mattmccrink/afc-drone/rpi_ros2/docs/RUNBOOK.md

# AFC Drone — Cold-Start Runbook (Pi → rosbridge → PC dashboard)

Every-time operation, from a powered-off Pi to live data in the browser.
(First-time install/config is in BRINGUP.md; this assumes it's all built.)

Chain:
```
PX4 ──TELEM2 ↔ Pi PL011 (serial0/ttyAMA0)──> uXRCE agent ─┐
                                                          ├─ ROS graph ─> rosbridge :9090 ─> browser (PC)
tiny(RP2350) Serial2 ↔ Pi uart3 (ttyAMA1) ──> bridge node ─┘
```

---

## 0. Power on — and check it
Power the Pi from a solid **5V/3A** supply (brownouts under load have bitten this
rig repeatedly). Once up and SSH'd in:
```bash
vcgencmd get_throttled        # want 0x0. nonzero = under-voltage; fix power first.
```

## 1. Get onto the Pi
The Pi is `phoenix` and answers to **`phoenix.local`** (mDNS) as well as its fixed
address `192.168.137.10`, over a cable or through the Doodle link (both bridge the
same Ethernet segment):
- `ssh pi@phoenix.local`   (or `ssh pi@192.168.137.10`)
- dashboard URL: `ws://192.168.137.10:9090` (the default), or `ws://phoenix.local:9090`.
  Prefer the IP over the radio: mDNS is multicast, and a mesh link may carry it poorly.

Once Wi-Fi is disabled (`sudo pi_setup.sh wifi-off`), the old hotspot
(`10.42.0.1`) no longer exists. If you are ever locked out, see *Recovery* in
`tools/pi_setup.sh`: every setting it makes can be undone from the SD card's boot
partition on any laptop.

## 2. Confirm the two serial devices
Both links are soldered GPIO UARTs (no USB, no FTDI). The FC is on `serial0`
(`ttyAMA0`); the Tiny is on `uart3` (`ttyAMA1`, base `fe201600`). **The Tiny is
never `ttyAMA0`.**
```bash
ls -l /dev/serial0                 # -> ttyAMA0
dmesg | grep -iE 'ttyAMA'          # fe201600 = uart3 = the Tiny
```

## 3. Source the environment (every terminal)
```bash
source /opt/ros/humble/setup.bash
source ~/afc-drone/rpi_ros2/install/setup.bash
```
(Put these two lines in ~/.bashrc so every new shell is ready.)

## 4+5. Start the agent + bridge (+ rosbridge) — one command
```bash
ros2 launch afc_bridge afc_system.launch.py      # defaults: agent_dev=/dev/serial0, serial_port=/dev/ttyAMA1
```
Watch for `create_client` / `create_participant` from the agent and
`opened /dev/ttyAMA1 (exclusive)` from the bridge (which also starts the #25873
keep-alive). Restarting the agent mid-session is recoverable on firmware built with
`patch_px4.py` steps 4-6: the FC reconnects a few seconds after the agent is back
(D1/D2, 2026-09-28). While DDS is down the arm token stalls; past 10 s the Tiny
reverts to SBUS. On older firmware an agent restart wedged the FC until a reboot.

Running pieces by hand instead:
```bash
MicroXRCEAgent serial --dev /dev/serial0 -b 921600                      # Terminal A
ros2 run afc_bridge bridge_node --ros-args -p serial_port:=/dev/ttyAMA1 # Terminal B
```

## 6. rosbridge (websocket :9090) — started by afc_system; by hand:
```bash
ros2 launch rosbridge_server rosbridge_websocket_launch.xml
```
Serves `ws://<pi-ip>:9090` on all interfaces. Can be started any time after the
graph is up (it just exposes existing topics).

## 7. Verify on the Pi (before touching the browser)
```bash
ros2 topic list                       # see /afc/* and /fmu/out/*
ros2 topic echo /afc/health           # serial up, ctrl/sensor/comp ~25 Hz, crc 0
ros2 topic echo /afc/compressor       # thermal_suspect false; rpm/temp when armed
ros2 topic hz /fmu/out/vehicle_torque_setpoint   # steady, max ~0.07s (NOT 1.0s)
# on the FC (nsh): uxrce_dds_client status  -> connected, Payload rx != 0
```

## 8. Open the dashboard on the PC
- Open `afc_dashboard.html` in a browser (next to QGC).
- Set the URL box to the address from step 1 (`ws://10.42.0.1:9090` hotspot, or
  `ws://192.168.137.10:9090` ethernet) and click **Connect**.
- Link dot goes green; valve schematic, charts, and health populate.

---

## 9. Preflight check (before every flight)
The agent and bridge normally start at boot as services (`microxrce-agent`,
`afc-bridge`); the preflight checks for those, so run it against the services, not a
hand-started stack. With the vehicle disarmed and the FC powered:
```bash
afc_preflight            # flight: sim/bench builds, missing venturis, no RC = FAIL
afc_preflight --bench    # bench: those become WARN
```
One PASS / WARN / FAIL line per check, ending GO or NO-GO (exit status 0 = GO).
Clear every FAIL before arming for flight.

## Shutdown
Ctrl-C the launch (or terminals C → B → A). The Tiny reverts to SBUS/SAFE when
the bridge stops (by design); if it was armed with no SBUS it terminates after 3 s.

## Quick troubleshooting
| Symptom | Check |
|---|---|
| Ethernet drops during heavy work | power/brownout — `vcgencmd get_throttled`; use `--parallel-workers 1` for builds |
| agent: no `create_client` | wrong `--dev`, baud, or MAVLink still on TELEM2 |
| bridge: `refusing to open ...` | `serial_port` points at the FC UART — the Tiny is `/dev/ttyAMA1` |
| dashboard red "ESC THERMAL" banner | ESC ≥ 90 °C and rpm sagging > 10 % below target ≥ 3 s — ESC likely self-derating |
| `/fmu/out/*` stalls ~1 Hz | bridge node not running (keep-alive only fires with it up) |
| topics exist but dashboard empty | wrong ws URL/IP, or message-type strings in the HTML CFG don't match `ros2 topic type` |
| dashboard link dot stays red | rosbridge not running, port 9090 blocked, or PC not on the Pi's subnet |
| `crc errors` climbing in health | serial/baud/desync on the tiny link |
| valve fills look wrong-scale | set `valveAbsMax` / bar full-scales in the HTML CFG block |
