mattmccrink/afc-drone/rpi_ros2/src/afc_bridge/afc_bridge/bridge_node.py

#!/usr/bin/env python3
"""
bridge_node.py -- Pi ROS2 supervisor/bridge between the Pixhawk (uXRCE-DDS) and
the RP2350 valve/sensor node over the Pi's uart3 (Tiny Serial2, 230400).

  Pixhawk --DDS--> [THIS NODE] --uart3(CMD,ARM)--> RP2350
  RP2350  --uart3(CTRL_TLM,SENSOR_TLM,COMP_TLM)--> [THIS NODE] --> ROS2 topics

Ports: the Tiny is on uart3 (PL011 @ fe201600 -> /dev/ttyAMA1 on this Pi). The FC
is on /dev/serial0 -> /dev/ttyAMA0 and belongs to the uXRCE-DDS agent: this node
refuses to open it (forbidden_ports) and opens its own port exclusively.

The node is a supervisor + bridge, NOT an in-loop controller: it forwards
pre-allocation control demand, relays the arm token with correct liveness
semantics, and republishes the tiny's telemetry as typed messages. Allocation
stays on the RP2350 (coanda-slot effectiveness + independent reversion); the FC
only supplies the normalised torque/thrust demand. All wire handling lives in
framing.py (byte-compatible with the tiny) and the arm-token safety logic in
arm_token.py; both are unit-tested off-hardware.

Command source (PX4 1.14+ control allocation, all uXRCE-DDS / px4_msgs):
  * CMD demand: vehicle_torque_setpoint (xyz = roll/pitch/yaw) +
    vehicle_thrust_setpoint (z = thrust), normalised [-1,1] body FRD, ~250 Hz.
    Rate-controller output PRE-allocation -- what FT_CMD expects, since the tiny
    does its own allocation.
  * ARM: vehicle_status.arming_state == ARMING_STATE_ARMED. STRICT boolean --
    the tiny does not reason about FC failsafe; the FC executes failsafe, which
    flips arming_state, which propagates here. QGC/arming/missions ride the
    Doodle MAVLink link straight to the FC, not this node.

Fail-safe intent preserved on the Pi side:
  * CMD is forwarded ONLY while BOTH setpoints (torque and thrust) are fresh --
    if either goes stale we stop sending, letting the tiny's USB_CMD_TIMEOUT_MS
    revert to SBUS.
  * the arm token advances ONLY while vehicle_status is fresh (see arm_token.py).
Both degrade toward the tiny's own reversion rather than freezing a last value.
"""
from __future__ import annotations

import time

import rclpy
from rclpy.node import Node
from rclpy.qos import QoSPresetProfiles

from std_msgs.msg import Header

from afc_bridge import framing as F
from afc_bridge.arm_token import ArmTokenTx
from afc_bridge.cmd_gate import setpoints_fresh
from afc_bridge.qgc_alert import AirAlerter, encode_text

# All FC I/O is px4_msgs over uXRCE-DDS now (no MAVROS). Resolved lazily so a
# plain `colcon build` doesn't hard-require px4_msgs at build time.
try:
    from px4_msgs.msg import (VehicleTorqueSetpoint, VehicleThrustSetpoint,
                              VehicleStatus, OffboardControlMode)
except Exception:  # pragma: no cover - present at runtime once px4_msgs is built
    VehicleTorqueSetpoint = VehicleThrustSetpoint = VehicleStatus = OffboardControlMode = None
try:
    from px4_msgs.msg import MavlinkLog
except Exception:  # pragma: no cover
    MavlinkLog = None

from afc_bridge_msgs.msg import ValveNodeCtrl, ValveNodeSensor, ValveNodeHealth, ValveNodeComp

_MODE_STR = {0: "DISARMED", 1: "PRIMARY_ARMED", 2: "SBUS_REVERSION",
             3: "SAFE_HOLD", 4: "TERMINATED"}

try:
    import serial  # pyserial
except Exception:  # pragma: no cover
    serial = None


class BridgeNode(Node):
    def __init__(self):
        super().__init__("afc_bridge")

        # ---- parameters ----
        p = self.declare_parameter
        self.port_name = p("serial_port", "/dev/ttyAMA1").value      # Tiny = uart3
        # Never open the FC's DDS UART from here (a second opener would inject
        # CMD/ARM frames into the FC link). Compared after resolving symlinks.
        self.forbidden_ports = list(p("forbidden_ports",
                                      ["/dev/serial0", "/dev/ttyAMA0"]).value)
        agent_port = str(p("agent_port", "").value)     # afc_system passes agent_dev
        if agent_port:
            self.forbidden_ports.append(agent_port)
        self.torque_topic = p("torque_topic", "/fmu/out/vehicle_torque_setpoint").value
        self.thrust_topic = p("thrust_topic", "/fmu/out/vehicle_thrust_setpoint").value
        # PX4 1.16+ publishes versioned messages under a _v1 suffix. vehicle_status
        # is a DEFAULT DDS publication so it carries the suffix; the setpoints below
        # are plain because they're hand-added to dds_topics.yaml under those names.
        self.status_topic = p("status_topic", "/fmu/out/vehicle_status_v1").value 
        # FRD z is down, so a multicopter's climb thrust is NEGATIVE in
        # thrust_setpoint.xyz[2]; the CMD throttle slot wants a positive
        # magnitude. Default -1 flips it; CONFIRM against live data before trust.
        self.thrust_sign = float(p("thrust_sign", -1.0).value)
        self.cmd_rate_hz = float(p("cmd_rate_hz", 50.0).value)
        self.cmd_stale_s = float(p("cmd_stale_after_s", 0.1).value)
        self.mdot_target = float(p("mdot_target_gps", 40.0).value)
        self.thrust_lo = float(p("thrust_lo", 0.0).value)
        self.thrust_hi = float(p("thrust_hi", 1.0).value)
        self.arm_hb_hz = float(p("arm_heartbeat_hz", 1.0).value)
        self.arm_stale_s = float(p("arm_stale_after_s", 0.5).value)
        self.ctrl_out = p("ctrl_topic", "/afc/ctrl_tlm").value
        self.sensor_out = p("sensor_topic", "/afc/sensor_tlm").value

        # ---- state ----
        self._ser = None
        self._reader = F.FrameReader()
        self._torque = None              # latest (x,y,z) = roll,pitch,yaw demand
        self._thrust = None              # latest (x,y,z); z is the thrust axis
        # Freshness is keyed on the OLDER of the two setpoints (cmd_gate): CMD
        # carries both, so a stalled thrust topic must not ride on live torque.
        self._torque_rx_mono = None      # monotonic arrival time of each setpoint
        self._thrust_rx_mono = None
        self._armtx = ArmTokenTx(
            send=self._send_arm,
            heartbeat_s=1.0 / self.arm_hb_hz,
            stale_after_s=self.arm_stale_s,
        )
        self._tlm_offset_ms = None       # est. (node_ms - ros_ms), for logging
        self._tlm_offset0_ms = None
        self.health_out = p("health_topic", "/afc/health").value
        # Air-delivery CAUTION/WARNING -> QGC via PX4 (mavlink_log -> STATUSTEXT).
        # Needs /fmu/in/mavlink_log in the FC's dds_topics.yaml; harmless without.
        self.qgc_alerts = bool(p("qgc_alerts", True).value)
        self.qgc_alert_topic = p("qgc_alert_topic", "/fmu/in/mavlink_log").value

        # ---- health/observability counters ----
        # With the console gone, a silent framing desync looks identical to
        # "no data" -- these make the difference visible. crc_errors lives on
        # the reader; the rest are tallied here and rolled into a 1 Hz rate.
        self._ctrl_count = 0             # CTRL_TLM frames since last health tick
        self._sensor_count = 0           # SENSOR_TLM frames since last health tick
        self._frames_ok = 0             # cumulative good frames
        self._last_source = 255          # from most recent CTRL_TLM (255 = none yet)
        self._last_armed = False
        # fault-tree fields from the tiny (CTRL_TLM ext; default = pre-update firmware)
        self._last_mode = 0
        self._last_term = False
        self._last_elig_fc = False
        self._last_elig_sbus = False
        self._last_sbus_sw = False
        self._last_desat_rp = 1.0
        self._last_desat_yaw = 1.0
        self._last_surf = False
        self._last_thermal = False
        self._last_air_sev = 0
        self._last_air_causes = 0
        self._health_t = time.monotonic()

        # ---- publishers ----
        self._ctrl_pub = self.create_publisher(ValveNodeCtrl, self.ctrl_out, 10)
        self._sensor_pub = self.create_publisher(ValveNodeSensor, self.sensor_out, 10)
        self._health_pub = self.create_publisher(ValveNodeHealth, self.health_out, 10)
        self._keepalive_pub = self.create_publisher(OffboardControlMode, "/fmu/in/offboard_control_mode",QoSPresetProfiles.SENSOR_DATA.value)
        self._alerter = AirAlerter()
        self._fc_ts_us = None            # latest FC timestamp (vehicle_status), for mavlink_log
        self._fc_ts_mono = 0.0
        self._qgc_pub = None
        if self.qgc_alerts and MavlinkLog is not None:
            self._qgc_pub = self.create_publisher(MavlinkLog, self.qgc_alert_topic,
                                                  QoSPresetProfiles.SENSOR_DATA.value)
        self.comp_out  = p("comp_topic", "/afc/compressor").value
        self._comp_pub = self.create_publisher(ValveNodeComp, self.comp_out, 10)
        self._comp_count = 0    # COMP_TLM frames since last health tick -> comp_hz
        # ---- subscribers ----
        # SENSOR_DATA QoS = best-effort/volatile/keep-last, which matches BOTH
        # MAVROS and PX4's uXRCE-DDS publishers. A default (reliable) QoS here is
        # the classic "topic exists but no messages arrive" trap against PX4.
        sensor_qos = QoSPresetProfiles.SENSOR_DATA.value
        if VehicleStatus is not None:
            self.create_subscription(VehicleStatus, self.status_topic,
                                     self._on_status, sensor_qos)
            self.create_subscription(VehicleTorqueSetpoint, self.torque_topic,
                                     self._on_torque, sensor_qos)
            self.create_subscription(VehicleThrustSetpoint, self.thrust_topic,
                                     self._on_thrust, sensor_qos)
        else:
            self.get_logger().error(
                "px4_msgs not importable; CMD+ARM inputs disabled. Build px4_msgs.")

        # ---- timers ----
        self.create_timer(1.0 / self.cmd_rate_hz, self._cmd_timer)
        self.create_timer(0.05, self._arm_timer)          # 20 Hz drive; TX self-paces
        self.create_timer(0.002, self._rx_timer)          # ~500 Hz serial drain
        self.create_timer(1.0, self._reconnect_timer)     # port keepalive
        self.create_timer(1.0, self._health_timer)        # 1 Hz health + rosout

        self._open_serial()
        self.get_logger().info(
            f"afc_bridge up: port={self.port_name} "
            f"cmd<=torque({self.torque_topic})+thrust({self.thrust_topic}) "
            f"arm<={self.status_topic} cmd_rate={self.cmd_rate_hz}Hz "
            f"arm_hb={self.arm_hb_hz}Hz mdot={self.mdot_target}g/s "
            f"thrust_sign={self.thrust_sign:+.0f}")
        self.create_timer(0.2, self._keepalive_timer)   # 5 Hz -- just keeps FC rx != 0

    def _keepalive_timer(self):
        # Inert message purely to keep uxrce_dds_client's Payload rx > 0, which
        # avoids the 1 s blocking ping (PX4 #25873). All fields false: commands
        # nothing. Real command authority is torque/thrust READ from the FC;
        # allocation is on the RP2350. This is a workaround for a firmware bug --
        # remove once the client is patched to gate connectivity on TX alone.
        m = OffboardControlMode()
        m.timestamp = int(self.get_clock().now().nanoseconds / 1000)  # PX4 wants microseconds
        m.position = False
        m.velocity = False
        m.acceleration = False
        m.attitude = False
        m.body_rate = False
        m.thrust_and_torque = False
        m.direct_actuator = False
        self._keepalive_pub.publish(m)
    # ---------------------------------------------------------------- serial
    def _port_forbidden(self) -> bool:
        import os
        try:
            me = os.path.realpath(self.port_name)
        except Exception:  # noqa: BLE001
            me = self.port_name
        for fp in self.forbidden_ports:
            if me == os.path.realpath(fp):
                return True
        return False

    def _open_serial(self):
        if serial is None:
            self.get_logger().error("pyserial not installed (python3-serial).")
            return
        if self._port_forbidden():
            self.get_logger().error(
                f"refusing to open {self.port_name}: it is the FC DDS port "
                f"({self.forbidden_ports}). The Tiny is on uart3 (/dev/ttyAMA1).")
            return
        try:
            # exclusive=True is pyserial's ADVISORY flock (stops other pyserial
            # users); TIOCEXCL below is the kernel-enforced lock: any further open()
            # of this tty by a non-root process fails with EBUSY.
            self._ser = serial.Serial(self.port_name, baudrate=230400, timeout=0,
                                      exclusive=True)
            try:
                import fcntl
                import termios
                fcntl.ioctl(self._ser.fileno(), termios.TIOCEXCL)
            except Exception as e:  # noqa: BLE001
                self.get_logger().warn(f"TIOCEXCL failed on {self.port_name} ({e})")
            self.get_logger().info(f"opened {self.port_name} (exclusive)")

        except Exception as e:  # noqa: BLE001
            self._ser = None
            self.get_logger().warn(f"serial open failed ({e}); will retry")

    def _reconnect_timer(self):
        if self._ser is None:
            self._open_serial()

    def _write(self, data: bytes):
        if self._ser is None:
            return
        try:
            self._ser.write(data)
        except Exception as e:  # noqa: BLE001
            self.get_logger().warn(f"serial write failed ({e}); dropping port")
            self._ser = None

    # ------------------------------------------------------------ subscribers
    def _on_status(self, msg):
        # STRICT: armed iff arming_state == ARMING_STATE_ARMED. No failsafe/nav
        # reasoning here -- the FC owns failsafe and flips arming_state, which
        # propagates through this one field. Freshness keyed on receipt time.
        armed = (msg.arming_state == VehicleStatus.ARMING_STATE_ARMED)
        self._armtx.note_state(armed, time.monotonic())
        # FC clock reference: PX4 drops a mavlink_log older than 5 s by ITS clock,
        # and with DDS timesync off the Pi must stamp in FC time itself.
        self._fc_ts_us = int(msg.timestamp)
        self._fc_ts_mono = time.monotonic()

    def _on_torque(self, msg):
        self._torque = (float(msg.xyz[0]), float(msg.xyz[1]), float(msg.xyz[2]))
        self._torque_rx_mono = time.monotonic()

    def _on_thrust(self, msg):
        self._thrust = (float(msg.xyz[0]), float(msg.xyz[1]), float(msg.xyz[2]))
        self._thrust_rx_mono = time.monotonic()

    def _cmd_fresh(self, now: float) -> bool:
        # both setpoints present, and the OLDER arrival within the window.
        return setpoints_fresh(now, self._torque_rx_mono, self._thrust_rx_mono,
                               self.cmd_stale_s)

    # ----------------------------------------------------------------- timers
    def _cmd_timer(self):
        if not self._cmd_fresh(time.monotonic()):
            return  # stale/incomplete setpoints -> stop forwarding, tiny reverts
        roll, pitch, yaw = self._torque          # torque xyz -> r/p/y demand
        thrust = self.thrust_sign * self._thrust[2]   # thrust axis, sign-corrected
        self._write(F.build_cmd(roll, pitch, yaw, thrust, self.mdot_target,
                                thrust_lo=self.thrust_lo, thrust_hi=self.thrust_hi))

    def _arm_timer(self):
        self._armtx.tick(time.monotonic())

    def _send_arm(self, armed: bool, counter: int):
        self._write(F.build_arm(armed, counter))

    def _rx_timer(self):
        if self._ser is None:
            return
        try:
            n = self._ser.in_waiting
            chunk = self._ser.read(n or 1)
        except Exception as e:  # noqa: BLE001
            self.get_logger().warn(f"serial read failed ({e}); dropping port")
            self._ser = None
            return
        if not chunk:
            return
        for fr in self._reader.feed(chunk):
            if fr.type == F.FT_CTRL_TLM:
                self._publish_ctrl(fr.payload)
            elif fr.type == F.FT_SENSOR_TLM:
                self._publish_sensor(fr.payload)
            elif fr.type == F.FT_COMP_TLM:
                self._publish_comp(fr.payload)
    # ------------------------------------------------------------- publishing
    def _stamp(self) -> Header:
        h = Header()
        h.stamp = self.get_clock().now().to_msg()
        return h

    def _publish_ctrl(self, payload: bytes):
        try:
            d = F.decode_ctrl_tlm(payload)
        except ValueError as e:
            self.get_logger().warn(str(e))
            return
        m = ValveNodeCtrl()
        m.header = self._stamp()
        m.source = d["source"]
        m.armed = d["armed"]
        m.comp_mode = d["comp_mode"]
        m.flow_fallback = d["flow_fallback"]
        m.rpm_target = d["rpm_target"]
        m.n_valid = d["n_valid"]
        m.valve = d["valve"]
        m.servo_us = d["servo_us"]
        m.surf_engaged = d["surf_engaged"]
        m.surf_switch = d["surf_switch"]
        m.surf = d["surf"]
        m.air_sev = d["air_sev"]
        m.air_causes = d["air_causes"]
        m.node_stamp_ms = int(d["node_stamp_ms"])
        for k in ("flags2_valid", "sbus_lost", "sbus_ok", "bench_build", "cal_flash",
                  "sim_sensors", "sim_sbus", "sim_primary"):
            setattr(m, k, bool(d[k]))
        m.sbus_stats_valid = bool(d["sbus_stats_valid"])
        for k in ("sbus_n_frames", "sbus_n_lost", "sbus_n_fs", "sbus_n_bad", "sbus_gap_ms"):
            setattr(m, k, int(d[k]))
        self._ctrl_pub.publish(m)
        self._qgc_alert(d["air_sev"], d["air_causes"], d["armed"])
        self._ctrl_count += 1
        self._frames_ok += 1
        self._last_source = d["source"]     # tiny's readback of our CMD path
        self._last_armed = d["armed"]       # tiny's readback of our arm token
        self._last_mode = d["mode"]         # fault-tree extras (0 on pre-update fw)
        self._last_term = d["terminated"]
        self._last_elig_fc = d["elig_fc"]
        self._last_elig_sbus = d["elig_sbus"]
        self._last_sbus_sw = d["sbus_sw"]
        self._last_desat_rp = d["desat_rp"]
        self._last_desat_yaw = d["desat_yaw"]
        self._last_surf = d["surf_engaged"]
        self._last_air_sev = d["air_sev"]
        self._last_air_causes = d["air_causes"]

    def _qgc_alert(self, level: int, causes: int, armed: bool):
        if self._qgc_pub is None:
            return
        for sev, text in self._alerter.update(int(level), int(causes), time.monotonic()):
            if self._fc_ts_us is None:
                self.get_logger().warn(f"[qgc] no FC clock yet, not sent: {text}")
                continue
            m = MavlinkLog()
            m.timestamp = self._fc_ts_us + int((time.monotonic() - self._fc_ts_mono) * 1e6)
            m.text = encode_text(text)
            m.severity = sev
            self._qgc_pub.publish(m)
            self.get_logger().info(f"[qgc] sev={sev} {text}")

    def _publish_sensor(self, payload: bytes):
        try:
            d = F.decode_sensor_tlm(payload)
        except ValueError as e:
            self.get_logger().warn(str(e))
            return
        m = ValveNodeSensor()
        m.header = self._stamp()
        m.node_stamp_ms = d["node_stamp_ms"]
        m.p_up = [float(x) for x in d["p_up"]]
        m.p_lo = [float(x) for x in d["p_lo"]]
        m.t_die = [float(x) for x in d["t_die"]]
        m.mdot = [float(x) for x in d["mdot"]]
        m.mdot_total = float(d["mdot_total"])
        m.valid = d["valid"]
        m.why = [int(x) & 0xFF for x in d["why"]]
        self._sensor_pub.publish(m)

        self._sensor_count += 1
        self._frames_ok += 1

        # running node<->ROS offset estimate (telemetry sanity / logging only).
        ros_ms = m.header.stamp.sec * 1000 + m.header.stamp.nanosec // 1_000_000
        raw = int(d["node_stamp_ms"]) - ros_ms
        if (self._tlm_offset0_ms is None
                or abs(raw - self._tlm_offset0_ms) > 2_000_000_000):
            self._tlm_offset0_ms = raw
        self._tlm_offset_ms = raw - self._tlm_offset0_ms
    
    def _publish_comp(self, payload: bytes):
        try:
            d = F.decode_comp_tlm(payload)
        except ValueError as e:
            self.get_logger().warn(str(e))
            return
        m = ValveNodeComp()
        m.header = self._stamp()
        m.volt = float(d["volt"])
        m.amp = float(d["amp"])
        m.rpm = int(d["rpm"])
        m.temp_c = int(d["temp_c"])
        m.err = int(d["err"])
        m.tlm_ok = bool(d["tlm_ok"])
        m.node_stamp_ms = int(d["node_stamp_ms"])
        m.thermal_suspect = bool(d["thermal_suspect"])
        self._comp_pub.publish(m)
        if m.thermal_suspect and not self._last_thermal:
            self.get_logger().warn(
                f"[comp] ESC THERMAL-DERATE SUSPECTED: {m.temp_c} C, {m.rpm} rpm")
        self._last_thermal = m.thermal_suspect
        self._comp_count += 1
        self._frames_ok += 1
    # ---------------------------------------------------------------- health
    def _health_timer(self):
        now = time.monotonic()
        dt = max(now - self._health_t, 1e-3)
        ctrl_hz = self._ctrl_count / dt
        sensor_hz = self._sensor_count / dt
        comp_hz = self._comp_count / dt
        self._ctrl_count = 0
        self._sensor_count = 0
        self._comp_count = 0
        self._health_t = now

        cmd_fresh = self._cmd_fresh(now)
        arm_fresh = not self._armtx.frozen

        m = ValveNodeHealth()
        m.header = self._stamp()
        m.serial_connected = self._ser is not None
        m.ctrl_hz = float(ctrl_hz)
        m.sensor_hz = float(sensor_hz)
        m.comp_hz = float(comp_hz)
        m.crc_errors = int(self._reader.crc_errors)
        m.frames_ok = int(self._frames_ok)
        m.last_source = int(self._last_source) if self._last_source != 255 else 255
        m.last_armed = bool(self._last_armed)
        m.mode = int(self._last_mode)
        m.mode_str = _MODE_STR.get(self._last_mode, "?")
        m.terminated = bool(self._last_term)
        m.elig_fc = bool(self._last_elig_fc)
        m.elig_sbus = bool(self._last_elig_sbus)
        m.sbus_sw = bool(self._last_sbus_sw)
        m.desat_rp = float(self._last_desat_rp)
        m.desat_yaw = float(self._last_desat_yaw)
        m.surf_engaged = bool(self._last_surf)
        m.air_sev = int(self._last_air_sev)
        m.air_causes = int(self._last_air_causes)
        m.air_str = F.AIR_NAMES.get(m.air_sev, "?") + "".join(
            " " + name for bit, name in F.AIR_CAUSES.items() if m.air_causes & bit)
        m.cmd_fresh = bool(cmd_fresh)
        m.arm_fresh = bool(arm_fresh)
        m.arm_counter = int(self._armtx.counter)
        raw_off = int(self._tlm_offset_ms) if self._tlm_offset_ms is not None else 0
        m.tlm_offset_ms = max(-2147483648, min(2147483647, raw_off))
        self._health_pub.publish(m)

        # human-readable 1 Hz line -- the 'health' console you lost, on rosout.
        src = {0: "PRIMARY", 1: "SBUS", 2: "SAFE", 255: "--"}.get(self._last_source, "?")
        self.get_logger().info(
            f"[health] ser={'up' if m.serial_connected else 'DOWN'} "
            f"ctrl={ctrl_hz:4.1f}Hz sens={sensor_hz:4.1f}Hz comp={comp_hz:4.1f}Hz crc={m.crc_errors} "
            f"mode={m.mode_str} src={src} armed={m.last_armed} term={m.terminated} "
            f"elig[fc={m.elig_fc} sbus={m.elig_sbus} sw={m.sbus_sw}] "
            f"cmd_fresh={m.cmd_fresh} arm_fresh={m.arm_fresh} "
            f"desat={m.desat_rp:.2f}/{m.desat_yaw:.2f} surf={m.surf_engaged} air=[{m.air_str}] "
            f"armctr={m.arm_counter} off={m.tlm_offset_ms}ms")


def main(args=None):
    rclpy.init(args=args)
    node = BridgeNode()
    try:
        rclpy.spin(node)
    except KeyboardInterrupt:
        pass
    finally:
        node.destroy_node()
        rclpy.shutdown()


if __name__ == "__main__":
    main()
