mattmccrink/afc-drone/rp2350_valve_node/sensors.ino

// =============================================================================
//  sensors.ino  --  REAL MS5837-02BA pipeline over PCA9548A  (core 1)
//
//  Compiled only when USE_REAL_I2C == 1 (otherwise sensors_sim.ino provides the
//  same seam). Two absolute -02BA per valve (upstream + throat); dp by
//  subtraction with a per-valve ground zero (g_dp_zero, from 'zero'); density
//  from the UPSTREAM absolute + its die temp. Between-sensor differential with
//  local static.
//
//  Pipeline: conversion-in-flight state machine. A conversion is kicked to all
//  sensors at once (broadcast: open every populated channel, one convert to
//  0x76), then read back sequentially CONV_LATENCY_TICKS later (one channel at a
//  time). Latency lets OSR 8192 (~18 ms) live under a 10 ms tick. The frame is
//  (re)published every tick so downstream staleness detection is unaffected.
//
//  Noise handling for the low-full-scale venturi: max OSR + a per-sensor EMA on
//  compensated pressure (SENS_EMA_ALPHA).
//
//  Mapping (open decision #1) is the editable table below. Convention: adjacent
//  channels per valve, lower channel = upstream (higher static) = ROLE_UP.
// =============================================================================
#include "config.h"
#include "types.h"

#if USE_REAL_I2C
#include <Wire.h>
#include "vent_health.h"

// ---------------------------------------------------------------------------
//  SENSOR MAP  --  EDIT as the tree populates (open decision #1).
//  Bench default: two sensors on mux 0x70, ch0 = valve0 upstream, ch1 = throat.
// ---------------------------------------------------------------------------
static const SensorSlot SENSOR_MAP[] = {
  //Left wing
  { ADDR_PCA9545_A, 0, 0, ROLE_UP },
  { ADDR_PCA9545_A, 1, 0, ROLE_LO },
  { ADDR_PCA9545_A, 2, 1, ROLE_UP },
  { ADDR_PCA9545_A, 3, 1, ROLE_LO },
  //Right wing
  { ADDR_PCA9545_B, 0, 2, ROLE_UP },
  { ADDR_PCA9545_B, 1, 2, ROLE_LO },
  { ADDR_PCA9545_B, 2, 3, ROLE_UP },
  { ADDR_PCA9545_B, 3, 3, ROLE_LO },
  //Canard
  { ADDR_PCA9545_C, 0, 4, ROLE_UP },
  { ADDR_PCA9545_C, 1, 4, ROLE_LO },
  { ADDR_PCA9545_C, 2, 5, ROLE_UP },
  { ADDR_PCA9545_C, 3, 5, ROLE_LO },
  // ---- example once fully populated (adjacent pairs, up = lower channel) ----
  // { 0x70, 2, 1, ROLE_UP }, { 0x70, 3, 1, ROLE_LO },
  // { 0x70, 4, 2, ROLE_UP }, { 0x70, 5, 2, ROLE_LO },
  // { 0x70, 6, 3, ROLE_UP }, { 0x70, 7, 3, ROLE_LO },
  // { 0x71, 0, 4, ROLE_UP }, { 0x71, 1, 4, ROLE_LO },
  // { 0x71, 2, 5, ROLE_UP }, { 0x71, 3, 5, ROLE_LO },
};
static const int N_SLOTS = sizeof(SENSOR_MAP) / sizeof(SENSOR_MAP[0]);

// ---- per-slot caches ----
static uint16_t s_prom[SENSOR_COUNT][8];
static bool     s_prom_ok[SENSOR_COUNT];
static uint32_t s_rawD1[SENSOR_COUNT], s_rawD2[SENSOR_COUNT];
static bool     s_have1[SENSOR_COUNT], s_have2[SENSOR_COUNT];
static float    s_P[SENSOR_COUNT], s_T[SENSOR_COUNT];   // s_P is EMA-filtered
static bool     s_ema_init[SENSOR_COUNT];

// ---- per-valve slot lookup ----
static int8_t   s_up[VALVE_COUNT], s_lo[VALVE_COUNT];

// ---- health (vent_health.h) ----
static SlotHealth s_h[SENSOR_COUNT];
static VentGate   s_gate[VALVE_COUNT];
static uint8_t    s_why[VALVE_COUNT];     // last published reason (console)

// ---- Valve constants ----
//ET and MMC calibration using Alicat mass flow sensor, 9/10/2026
static float K_VENTURI[6] =   {0.8963f,0.8425f,0.876f,0.8425f,0.8705f,0.8496f}; //~31 mBar at 400 SLPM

// ---- unique mux list ----
static uint8_t  s_mux[8]; static int s_nmux = 0;

// ---- pipeline state (conversion-in-flight; supports multi-tick latency) ----
static bool     s_conv_pending    = false;
static uint32_t s_conv_ready_tick = 0;
static int      s_conv_type       = 0;    // 0 = D1 pressure, 1 = D2 temperature
static uint32_t s_conv_count      = 0;    // conversions issued (drives D2 cadence)

// ---------------------------------------------------------------------------
//  MS5837-02BA compensation (validated at bring-up). 64-bit intermediates.
// ---------------------------------------------------------------------------
static void ms_compensate(const uint16_t prom[8], uint32_t D1, uint32_t D2,
                          float& p_mbar, float& t_C) {
  int64_t C1=prom[1], C2=prom[2], C3=prom[3], C4=prom[4], C5=prom[5], C6=prom[6];
  int64_t dT   = (int64_t)D2 - (C5 << 8);
  int64_t TEMP = 2000 + (dT * C6) / 8388608LL;
  int64_t OFF  = (C2 << 17) + (C4 * dT) / 64;
  int64_t SENS = (C1 << 16) + (C3 * dT) / 128;
  int64_t Ti=0, OFFi=0, SENSi=0;
  if (TEMP < 2000) {
    int64_t d = TEMP - 2000;
    Ti    = (11 * dT * dT) >> 35;
    OFFi  = (31 * d * d) >> 3;
    SENSi = (63 * d * d) >> 5;
  }
  OFF -= OFFi; SENS -= SENSi;
  int64_t P = ((((int64_t)D1 * SENS) >> 21) - OFF) >> 15;
  p_mbar = P / 100.0f;
  t_C    = (TEMP - Ti) / 100.0f;
}

// ---------------------------------------------------------------------------
//  Mux + MS5837 low level
// ---------------------------------------------------------------------------
static void mux_select_only(uint8_t target, uint8_t ch) {
  for (int i = 0; i < s_nmux; ++i) {
    if (!i2c_ok()) return;             // breaker open (always true during setup)
    Wire.beginTransmission(s_mux[i]);
    Wire.write(s_mux[i] == target ? (uint8_t)(1u << ch) : (uint8_t)0x00);
    Wire.endTransmission();
  }
}

static void mux_open_all_populated() {
  for (int i = 0; i < s_nmux; ++i) {
    uint8_t mask = 0;
    for (int k = 0; k < N_SLOTS; ++k) if (SENSOR_MAP[k].mux == s_mux[i]) mask |= (1u << SENSOR_MAP[k].ch);
    if (!i2c_ok()) return;
    Wire.beginTransmission(s_mux[i]);
    Wire.write(mask);
    Wire.endTransmission();
  }
}

static bool ms_read_adc(uint32_t& out) {
  Wire.beginTransmission(ADDR_MS5837);
  Wire.write(MS_ADC_READ_CMD);
  if (Wire.endTransmission() != 0) return false;
  if (Wire.requestFrom((int)ADDR_MS5837, 3) != 3) return false;
  out = ((uint32_t)Wire.read() << 16) | ((uint32_t)Wire.read() << 8) | Wire.read();
  return true;
}

static void mux_close_all() {
  for (int i = 0; i < s_nmux; ++i) {
    if (!i2c_ok()) return;
    Wire.beginTransmission(s_mux[i]);
    Wire.write(0x00);              // all channels off
    Wire.endTransmission();
  }
}

static uint8_t ms_crc4(uint16_t prom[8]) {
  uint16_t rem = 0, saved0 = prom[0];
  prom[0] &= 0x0FFF; prom[7] = 0;
  for (int cnt = 0; cnt < 16; cnt++) {
    if (cnt % 2 == 1) rem ^= (uint16_t)(prom[cnt >> 1] & 0x00FF);
    else              rem ^= (uint16_t)(prom[cnt >> 1] >> 8);
    for (uint8_t b = 8; b > 0; b--)
      rem = (rem & 0x8000) ? (uint16_t)((rem << 1) ^ 0x3000) : (uint16_t)(rem << 1);
  }
  prom[0] = saved0;
  return (uint8_t)((rem >> 12) & 0x0F);
}

static bool ms_read_prom(int slot) {
  Wire.beginTransmission(ADDR_MS5837); Wire.write(MS_RESET_CMD); Wire.endTransmission();
  delay(12);
  for (uint8_t w = 0; w < 7; ++w) {
    Wire.beginTransmission(ADDR_MS5837); Wire.write((uint8_t)(0xA0 + w * 2));
    if (Wire.endTransmission() != 0) return false;
    if (Wire.requestFrom((int)ADDR_MS5837, 2) != 2) return false;
    s_prom[slot][w] = ((uint16_t)Wire.read() << 8) | Wire.read();
  }
  uint16_t tmp[8]; memcpy(tmp, s_prom[slot], sizeof(tmp));
  return ((s_prom[slot][0] >> 12) & 0x0F) == ms_crc4(tmp);
}

// Reprintable boot/health summary for the sensor path (also called at setup).
void sensors_health_print() {
  Serial.println(F("[health] sensor path: REAL (MS5837-02BA)"));
  for (int k = 0; k < N_SLOTS; ++k)
    Serial.printf("[health] slot%d mux0x%02X ch%u valve%u %s : PROM %s\n",
                  k, SENSOR_MAP[k].mux, SENSOR_MAP[k].ch, SENSOR_MAP[k].valve,
                  SENSOR_MAP[k].role == ROLE_UP ? "UP" : "LO",
                  s_prom_ok[k] ? "OK" : "FAIL");
}

// Per-venturi reason + per-sensor counters ('vhealth'). Runs on core 0 and
// reads core-1 counters without a lock: 32-bit reads are atomic, so each
// number is real, but a line can mix values from adjacent ticks. Diagnostic only.
void sensors_vhealth_print() {
  uint32_t now = millis();
  Serial.println(F("[vh] venturi  reason     (valid = OK; fallback if fewer than MIN_VALID_VALVES)"));
  for (int v = 0; v < VALVE_COUNT; ++v)
    Serial.printf("[vh] v%d       %s\n", v, vh_name(s_why[v]));
  Serial.println(F("[vh] slot mux  ch valve role state    ok      fail    spike  stale_ev frozen_ev lossy_ev score same d1_age_ms"));
  for (int k = 0; k < N_SLOTS; ++k) {
    const SlotHealth& h = s_h[k];
    Serial.printf("[vh] %-4d 0x%02X %-2u %-5u %-4s %-8s %-7lu %-7lu %-6lu %-8lu %-9lu %-8lu %-5u %-4u %ld\n",
      k, SENSOR_MAP[k].mux, SENSOR_MAP[k].ch, SENSOR_MAP[k].valve,
      SENSOR_MAP[k].role == ROLE_UP ? "UP" : "LO", vh_name(h.state),
      (unsigned long)h.n_ok, (unsigned long)h.n_fail, (unsigned long)h.n_spike,
      (unsigned long)h.n_stale_ev, (unsigned long)h.n_frozen_ev, (unsigned long)h.n_lossy_ev,
      (unsigned)h.fail_score, (unsigned)h.same_d1,
      h.seen_d1 ? (long)(now - h.last_d1_ms) : -1L);
  }
}

// ---------------------------------------------------------------------------
//  Setup: build mux list + valve lookup, cache PROM per sensor
// ---------------------------------------------------------------------------
void sensors_setup() {
  static_assert(sizeof(SENSOR_MAP) / sizeof(SENSOR_MAP[0]) <= SENSOR_COUNT,
                "SENSOR_MAP has more slots than SENSOR_COUNT");
  for (int v = 0; v < VALVE_COUNT; ++v) { s_up[v] = -1; s_lo[v] = -1; s_why[v] = VH_NODATA; }
  s_nmux = 0;

  for (int k = 0; k < N_SLOTS; ++k) {
    const SensorSlot& s = SENSOR_MAP[k];
    if (s.role == ROLE_UP) s_up[s.valve] = k; else s_lo[s.valve] = k;
    bool seen = false;
    for (int i = 0; i < s_nmux; ++i) if (s_mux[i] == s.mux) seen = true;
    if (!seen && s_nmux < (int)sizeof(s_mux)) s_mux[s_nmux++] = s.mux;
    s_have1[k] = s_have2[k] = false;
    s_ema_init[k] = false;
  }

  for (int k = 0; k < N_SLOTS; ++k) {
    mux_select_only(SENSOR_MAP[k].mux, SENSOR_MAP[k].ch);
    s_prom_ok[k] = ms_read_prom(k);
  }
  sensors_health_print();   // best-effort at boot; also available via 'health'
}

// ---------------------------------------------------------------------------
//  100 Hz tick
// ---------------------------------------------------------------------------
void sensors_tick(uint32_t tick) {
  uint32_t now = millis();

  // ---- 1) read back a conversion that has become ready ----
  if (s_conv_pending && (int32_t)(tick - s_conv_ready_tick) >= 0) {
    for (int k = 0; k < N_SLOTS; ++k) {
      if (!s_prom_ok[k]) continue;
      if (!i2c_ok()) break;                 // breaker open: unread slots age toward STALE
      mux_select_only(SENSOR_MAP[k].mux, SENSOR_MAP[k].ch);
      if (!i2c_ok()) break;                 // never read through a half-done mux select
      uint32_t raw = 0;
      bool xfer = ms_read_adc(raw);
      // Bad transfers, 0 / 0xFFFFFF and D1 spikes never reach compensation.
      if (sh_on_read(s_h[k], s_conv_type, xfer, raw, now)) {
        if (s_conv_type == 0) { s_rawD1[k] = raw; s_have1[k] = true; }
        else                  { s_rawD2[k] = raw; s_have2[k] = true; }
      }
      if (s_have1[k] && s_have2[k]) {
        float P, T;
        ms_compensate(s_prom[k], s_rawD1[k], s_rawD2[k], P, T);
        if (!s_ema_init[k]) { s_P[k] = P; s_ema_init[k] = true; }
        else                  s_P[k] += SENS_EMA_ALPHA * (P - s_P[k]);   // EMA on pressure
        s_T[k] = T;                                                      // temp slow: unfiltered
      }
    }
    s_conv_pending = false;
    mux_close_all();
  }

  // ---- 2) health: evaluate every sensor slot ----
  uint8_t sh[SENSOR_COUNT];
  for (int k = 0; k < SENSOR_COUNT; ++k) sh[k] = VH_UNMAPPED;
  for (int k = 0; k < N_SLOTS; ++k) {
    sh[k] = sh_eval(s_h[k], s_prom_ok[k], now);
    // A faulted slot restarts its EMA on recovery instead of blending from a
    // value that may be long stale.
    if (sh[k] == VH_STALE || sh[k] == VH_FROZEN || sh[k] == VH_LOSSY) s_ema_init[k] = false;
  }

  // ---- 3) assemble + publish per-valve frame (every tick; holds between updates) ----
  SensorFrame out{};   // built locally; published below in one short copy (types.h)
  float total = 0.0f; uint8_t nvalid = 0;

  for (int v = 0; v < VALVE_COUNT; ++v) {
    int up = s_up[v], lo = s_lo[v];
    bool mapped = (up >= 0 && lo >= 0);
    // Values are published whenever data exists (so a frozen / stale reading
    // stays visible for diagnosis); VALIDITY is decided separately below.
    bool paired = mapped && s_prom_ok[up] && s_prom_ok[lo] && s_have1[up] && s_have1[lo];

    float pu = paired ? s_P[up] : 0.0f;
    float pl = paired ? s_P[lo] : 0.0f;
    float td = paired ? s_T[up] : 0.0f;   // density temp from the upstream sensor

    bool range_ok = paired &&
                    pu >= MS_P_RANGE_MIN && pu <= MS_P_RANGE_MAX &&
                    pl >= MS_P_RANGE_MIN && pl <= MS_P_RANGE_MAX &&
                    td >= MS_T_RANGE_MIN && td <= MS_T_RANGE_MAX;

    float dp = ((pu - pl) - g_dp_zero[v]);          // zero-corrected differential (mbar)

    // VALIDITY = sensor + pair health only. Flow presence is a separate
    // deadband test, so a healthy venturi at zero flow still counts.
    VentInputs vin;
    vin.mapped   = mapped;
    vin.sh_up    = mapped ? sh[up] : (uint8_t)VH_UNMAPPED;
    vin.sh_lo    = mapped ? sh[lo] : (uint8_t)VH_UNMAPPED;
    vin.injected = g_fault_valve[v] || g_fault_aggregate;
    vin.range_ok = range_ok;
    vin.dp_corr  = dp;
    uint8_t why  = vent_gate(s_gate[v], vent_reason(vin), now);
    bool valid   = (why == VH_OK);
    s_why[v]     = why;

    float mdot = 0.0f;
    if (valid) {
      if (dp >= VENTURI_DP_MIN) {                 // above the noise deadband -> real flow
        float rho = (pu * 100.0f) / (R_AIR * (td + 273.15f));   // ideal gas, upstream static
        mdot = K_VENTURI[v] * AREA_INLET* rho * sqrtf(2.0f * dp * 100.0f/ (rho * (AREA_RATIO * AREA_RATIO - 1) )) *1000;     // dp mbar -> Pa; guarded dp>0, mdot kg-->g is *1000
      }
      total += mdot;                              // 0 when below deadband (no phantom flow)
      nvalid++;                                   // healthy sensor counts, flowing or not
    }

    out.p_up[v]  = pu;
    out.p_lo[v]  = pl;
    out.t_die[v] = td;                                   // upstream (density temp)
    out.t_lo[v]  = paired ? s_T[lo] : 0.0f;              // throat (cal/tempco)
    out.mdot[v]  = mdot;
    out.valid[v] = valid ? 1 : 0;
    out.why[v]   = why;
  }

  out.mdot_total = total;
  out.n_valid    = nvalid;
  for (int s = 0; s < SERVO_COUNT; ++s) out.servo_us[s] = g_servo_us_echo[s];
  g_sensor_pub.publish(out);

  // ---- 4) if nothing is in flight, kick the next conversion (broadcast) ----
  if (!s_conv_pending && i2c_ok()) {
    int type = ((s_conv_count % D2_CADENCE_TICKS) == 0) ? 1 : 0;   // D2 temp vs D1 pressure
    mux_open_all_populated();
    if (!i2c_ok()) return;                  // muxes not all open: don't start a conversion
    Wire.beginTransmission(ADDR_MS5837);
    Wire.write(type ? MS_D2_CMD : MS_D1_CMD);
    Wire.endTransmission();
    if (!i2c_ok()) return;                  // convert command timed out: retry after back-off
    s_conv_type       = type;
    s_conv_ready_tick = tick + CONV_LATENCY_TICKS;
    s_conv_pending    = true;
    s_conv_count++;
  }
}

#endif // USE_REAL_I2C
