mattmccrink/afc-drone/rp2350_valve_node/console.ino

// =============================================================================
//  console.ino  --  Human bench console over USB CDC  (core 0)
//
//  Drives the whole node on a bare board: force sources, arm/disarm, simulate
//  primary loss and SBUS failsafe, set sticks and mass-flow target, inject
//  sensor faults, and save calibration. Line-based; type 'help'.
// -----------------------------------------------------------------------------
#include "config.h"
#include "air_state.h"

static bool    con_mon_on = false;
static bool    con_pstream = false;   // 2 Hz LabVIEW pressure stream
// servo bring-up sweep state (core 0 computes waveform, core 1 writes)
static bool    sweep_active = false;
static uint16_t sweep_min = 1000, sweep_max = 2000;
static uint32_t sweep_ms = 2000, sweep_t0 = 0;
static char    con_line[96];
static uint8_t con_len = 0;
// servo step state (core0 computes staircase; core1 writes via the man table)
static bool     step_active = false;
static uint16_t step_begin = 1000, step_end = 2000;
static int32_t  step_size  = 100;      // us per step (sign set from begin/end)
static uint32_t step_dwell = 200;      // ms held at each step
static uint32_t step_t0    = 0;

static const char* src_name(Source s) {
  switch (s) { case SRC_PRIMARY: return "PRIMARY"; case SRC_SBUS: return "SBUS"; default: return "SAFE"; }
}
static const char* mode_name(CompMode m) {
  switch (m) { case COMP_TRACK: return "TRACK"; case COMP_DIRECT: return "DIRECT";
               case COMP_FALLBACK: return "FALLBACK"; default: return "STOPPED"; }
}

static void print_status() {
  Serial.printf(
    "[st] src=%-7s arm=%d(live=%d) term=%d prim=%d | elig fc=%d sbus=%d sw=%d | comp=%-8s rpm=%5u%s | mdot=%.1f/%.1f g/s nvalid=%u%s%s | air=%s(0x%02X) | v=[%d %d %d %d %d %d] surf=%s[%d %d %d %d] desat=%.2f/%.2f | cal=%s | hb=%lu drop=%lu\n",
    src_name(g_status.source), g_status.armed?1:0, g_status.arm_live?1:0, g_status.terminated?1:0, g_status.primary_present?1:0,
    arb_fc_eligible()?1:0, g_sbus_arm_seen_disarmed?1:0, g_sbus_arm?1:0,
    mode_name(g_status.comp_mode), g_status.rpm_target, g_status.comp_thermal ? " THERMAL" : "",
    (double)g_status.mdot_total, (double)g_status.mdot_target, g_status.n_valid,
    g_status.flow_fallback ? " FALLBACK" : "", g_status.sensor_stale ? " STALE" : "",
    air_name(g_status.air_sev), g_status.air_causes,
    g_valve_dbg[0], g_valve_dbg[1], g_valve_dbg[2], g_valve_dbg[3], g_valve_dbg[4], g_valve_dbg[5],
    g_status.surf_active ? (g_surf_force >= 0 ? "ON(forced)" : "ON")
      : g_status.surf_engaged ? "sw-on/idle" : (g_surf_force >= 0 ? "off(forced)" : "off"),
    g_surf_dbg[0], g_surf_dbg[1], g_surf_dbg[2], g_surf_dbg[3],
    (double)g_alloc_s_rp, (double)g_alloc_s_yaw,
    g_cal_from_flash ? "flash" : "default", (unsigned long)g_core1_heartbeat, (unsigned long)g_tlm_dropped);
}

static void print_help() {
  Serial.println(F(
    "commands:\n"
    "  help                    this list\n"
    "  status                  one-shot status line\n"
    "  health                  reprint boot/health summary (sensor PROM, cal, liveness)\n"
    "  mon on|off              periodic status line (2 Hz)\n"
    "  src auto|primary|sbus|safe   force/release the active source\n"
    "  surf on|off|auto        force traditional surfaces / follow the SBUS switch (bench)\n"
    "  arm | disarm            simulated Pixhawk arm channel\n"
    "  prim on|off             simulate primary (Pi) presence\n"
    "  sbusfs on|off           simulate SBUS failsafe flag\n"
    "  sbuslost on|off         simulate SBUS frame-lost flag\n"
    "  sbus                    print real SBUS decode (raw ch, arm, surf)\n"
    "  stick R P Y T           set SBUS sticks (floats: roll pitch yaw throttle)\n"
    "  fault valve N on|off    inject per-valve sensor fault (N=0..5)\n"
    "  fault agg on|off        inject aggregate flow fault\n"
    "  mdot X                  set mass-flow target (g/s)\n"
    "  sens                    dump per-valve p_up/p_lo/dp/T/mdot from the frame\n"
    "  pstream on|off          2 Hz LabVIEW stream: !A=12 pressures, !B=12 temps\n"
    "  servo <A|B|C> <ch> <us> drive one PCA9685 channel (bring-up); servo off to stop\n"
    "  sweep <A|B|C> <ch> [min max ms]  triangle-sweep one channel (default 1000 2000 2000)\n"
    "  step <A|B|C> <ch> [min max step_us hold_ms]  step one channel (default 1000 2000 100 200)\n"
    "  save                    persist current calibration to LittleFS\n"
    "  map                     print servo -> valve map (servo s = board s/4, channel s%4)\n"
    "  map S V                 assign servo S (0..11) to valve V (0..5); 'save' to keep (I13)\n"
    "  zero                    capture no-flow dp offset per valve, then save\n"
    "  calshow                 calibration: all 12 servo fits (checked), gain/bias, dp_zero\n"
    "  vhealth                 per-venturi validity reason + per-sensor read/fault counters\n"
    "  air                     air-delivery severity, causes and the inputs behind them"));
#if BENCH_HOOKS
  Serial.println(F(
    "bench hooks (BENCH_HOOKS=1 -- not a flight build):\n"
    "  hang core0|core1        stall a core -> watchdog reset (T-S3 / T-S7)\n"
    "  tdrop N                 skip the next N Teensy frames, 20 ms each (T-C4 / T-C5)\n"
    "  i2cstick sda|scl <ms>|hold|persist N|off, i2cstick probe on|off\n"
    "                          hold an I2C line low at the pad: a stuck device (needs USE_REAL_I2C)"));
#endif
}

static bool eq(const char* a, const char* b) { return strcmp(a, b) == 0; }

// Resolve a servo-driver name to a device index: A/B/C (any case) or 0/1/2.
static int dev_index(const char* s) {
  if (!strcasecmp(s, "A") || eq(s, "0")) return 0;
  if (!strcasecmp(s, "B") || eq(s, "1")) return 1;
  if (!strcasecmp(s, "C") || eq(s, "2")) return 2;
  return -1;
}
static bool onoff(const char* s, bool& out) {
  if (eq(s,"on"))  { out = true;  return true; }
  if (eq(s,"off")) { out = false; return true; }
  return false;
}

// Triangle sweep position for the elapsed time in the period: min..max..min.
static uint16_t sweep_us_at(uint32_t now) {
  uint32_t p    = (now - sweep_t0) % sweep_ms;
  float    ph   = (float)p / (float)sweep_ms;                    // 0..1
  float    frac = (ph < 0.5f) ? (2.0f * ph) : (2.0f - 2.0f * ph); // 0..1..0
  return sweep_min + (uint16_t)lroundf(frac * (float)(sweep_max - sweep_min));
}

static void dispatch(char* line) {
  // tokenize on spaces
  char* tok[8]; int n = 0;
  char* p = strtok(line, " \t");
  while (p && n < 8) { tok[n++] = p; p = strtok(nullptr, " \t"); }
  if (n == 0) return;

  if (eq(tok[0], "help"))        { print_help(); }
  else if (eq(tok[0], "status")) { print_status(); }
  else if (eq(tok[0], "health")) {
    Serial.println(F("RP2350 valve/sensor node -- health"));
    Serial.printf("[health] last reset cause=%s  uptime=%lu s\n",
                  g_reset_cause, (unsigned long)(millis() / 1000));
    Serial.printf("[health] core1 heartbeat=%lu (should advance between calls)\n",
                  (unsigned long)g_core1_heartbeat);
    Serial.printf("[health] cal source=%s\n", g_cal_from_flash ? "flash" : "default");
    sensors_health_print();
    servos_health_print();
    i2c_guard_print();
    sensors_vhealth_print();
  }
  else if (eq(tok[0], "vhealth")) { sensors_vhealth_print(); }
  else if (eq(tok[0], "air")) {
    // held = why the displayed level is lit (what the dashboard/QGC show);
    // now = this instant. They differ while an intermittent fault holds the level up.
    for (int k = 0; k < 2; ++k) {
      uint8_t c = k ? g_status.air_causes_now : g_status.air_causes;
      if (k == 0)
        Serial.printf("[air] severity=%s  held=0x%02X", air_name(g_status.air_sev), c);
      else
        Serial.printf("[air] now=0x%02X", c);
      Serial.printf("%s%s%s%s%s%s%s", (c & AIR_C_TLM_LOST) ? " TLM_LOST" : "", (c & AIR_C_TLM_EMU) ? " TLM_EMU" : "",
        (c & AIR_C_VENT_PARTIAL) ? " VENT_PARTIAL" : "", (c & AIR_C_VENT_LOST) ? " VENT_LOST" : "",
        (c & AIR_C_FLOW_LOW) ? " FLOW_LOW" : "", (c & AIR_C_SENSOR_STALE) ? " SENSOR_STALE" : "",
        (c & AIR_C_TEENSY_LINK) ? " TEENSY_LINK" : "");
      if (k == 0 && g_status.air_sev != AIR_OK)
        Serial.printf("  (last seen %lu ms ago)", (unsigned long)(millis() - g_status.air_held_ms));
      Serial.println();
    }
    Serial.printf("[air] inputs: armed=%d term=%d teensy_ok=%d err=%d nvalid=%u stale=%d mdot=%.1f g/s (min %.1f)\n",
      g_status.armed?1:0, g_status.terminated?1:0, g_comp.ok?1:0, (int)g_comp.err,
      g_status.n_valid, g_status.sensor_stale?1:0, (double)g_status.mdot_total, (double)AIR_MDOT_MIN_GPS);
  }
  else if (eq(tok[0], "hang") || eq(tok[0], "tdrop")) {
#if BENCH_HOOKS
    if (eq(tok[0], "hang") && n >= 2 && eq(tok[1], "core0")) {
      // Core 0 stops here: no more WDT pets -> hardware reset in ~WDT_TIMEOUT_MS.
      // Core 1 keeps running and, after CMD_TIMEOUT_MS, drives the safe pose.
      Serial.println(F("[hang] core0 spinning; expect safe pose, then WATCHDOG reset"));
      Serial.flush();
      for (;;) { tight_loop_contents(); }
    } else if (eq(tok[0], "hang") && n >= 2 && eq(tok[1], "core1")) {
      // Core 1 stops; core 0 sees the heartbeat stall (CORE1_STALL_TRIP_MS),
      // withholds the pet -> reset. PCA9685s hold their last pulse meanwhile.
      g_hang_core1 = true;
      Serial.println(F("[hang] core1 spinning; expect WATCHDOG reset"));
    } else if (eq(tok[0], "tdrop") && n >= 2) {
      int k = atoi(tok[1]);
      if (k < 1 || k > 250) Serial.println(F("[tdrop] N must be 1..250"));
      else { g_tdrop = (uint16_t)k;
             Serial.printf("[tdrop] skipping next %d Teensy frame(s) (~%d ms; only while armed)\n",
                           k, k * (1000 / TEENSY_STREAM_HZ)); }
    } else Serial.println(F("usage: hang core0|core1 | tdrop N"));
#else
    Serial.println(F("[bench] hooks not compiled in (BENCH_HOOKS=0)"));
#endif
  }
  else if (eq(tok[0], "i2cstick")) {
#if BENCH_HOOKS
    bench_i2c_command(tok, n);
#else
    Serial.println(F("[bench] hooks not compiled in (BENCH_HOOKS=0)"));
#endif
  }
  else if (eq(tok[0], "mon") && n >= 2)  { onoff(tok[1], con_mon_on); }
  else if (eq(tok[0], "pstream") && n >= 2) {
    bool b; if (onoff(tok[1], b)) {
      con_pstream = b;
      if (b) {                              // one-time column headers for LabVIEW
        Serial.print("!HA");
        for (int v = 0; v < VALVE_COUNT; ++v) Serial.printf(",v%d_up,v%d_lo", v, v);
        Serial.println();
        Serial.print("!HB");
        for (int v = 0; v < VALVE_COUNT; ++v) Serial.printf(",v%d_up,v%d_lo", v, v);
        Serial.println();
      }
    }
  }
  else if (eq(tok[0], "surf") && n >= 2) {
    if      (eq(tok[1], "auto")) g_surf_force = -1;
    else if (eq(tok[1], "on"))   g_surf_force = 1;
    else if (eq(tok[1], "off"))  g_surf_force = 0;
    Serial.printf("[surf] %s\n", g_surf_force < 0 ? "follow SBUS switch" : (g_surf_force ? "FORCED ON" : "FORCED OFF"));
  }
  else if (eq(tok[0], "src") && n >= 2) {
    if      (eq(tok[1],"auto"))    arbitration_force(SRC_SAFE, false);
    else if (eq(tok[1],"primary")) arbitration_force(SRC_PRIMARY, true);
    else if (eq(tok[1],"sbus"))    arbitration_force(SRC_SBUS, true);
    else if (eq(tok[1],"safe"))    arbitration_force(SRC_SAFE, true);
    Serial.printf("[src] %s\n", tok[1]);
  }
  else if (eq(tok[0], "arm"))    { g_sim_arm_intent = true;  Serial.println(F("[arm] intent=ARMED")); }
  else if (eq(tok[0], "disarm")) { g_sim_arm_intent = false; Serial.println(F("[arm] intent=DISARMED")); }
  else if (eq(tok[0], "prim") && n >= 2) {
    bool b; if (onoff(tok[1], b)) { g_status.primary_present = b; Serial.printf("[prim] %d\n", b?1:0); }
  }
  else if (eq(tok[0], "sbusfs") && n >= 2)   { bool b; if (onoff(tok[1], b)) g_sbus_failsafe  = b; }
  else if (eq(tok[0], "sbuslost") && n >= 2) { bool b; if (onoff(tok[1], b)) g_sbus_framelost = b; }
  else if (eq(tok[0], "stick") && n >= 5) {
    g_sbus_in.roll     = atof(tok[1]);
    g_sbus_in.pitch    = atof(tok[2]);
    g_sbus_in.yaw      = atof(tok[3]);
    g_sbus_in.throttle = atof(tok[4]);
    Serial.printf("[stick] r=%.2f p=%.2f y=%.2f t=%.2f\n",
      (double)g_sbus_in.roll,(double)g_sbus_in.pitch,(double)g_sbus_in.yaw,(double)g_sbus_in.throttle);
  }
  else if (eq(tok[0], "fault") && n >= 3) {
    if (eq(tok[1], "agg")) { bool b; if (onoff(tok[2], b)) { g_fault_aggregate = b; Serial.printf("[fault] agg=%d\n", b?1:0);} }
    else if (eq(tok[1], "valve") && n >= 4) {
      int idx = atoi(tok[2]); bool b;
      if (idx >= 0 && idx < VALVE_COUNT && onoff(tok[3], b)) { g_fault_valve[idx] = b; Serial.printf("[fault] valve%d=%d\n", idx, b?1:0);}
    }
  }
  else if (eq(tok[0], "servo")) {
    if (n >= 2 && eq(tok[1], "off")) {
      g_servo_manual = false; sweep_active = false;
        for (int d = 0; d < PCA9685_COUNT; ++d)
        for (int c = 0; c < PCA9685_MAX_CH; ++c) g_servo_man_tbl[d][c] = 0;
      Serial.println(F("[servo] manual OFF (back to curve-fit path)"));
    } else if (n >= 4) {
      int d = dev_index(tok[1]); int ch = atoi(tok[2]); int us = atoi(tok[3]);
      if (d < 0)                              Serial.println(F("[servo] bad device (A/B/C)"));
      else if (ch < 0 || ch >= PCA9685_MAX_CH) Serial.printf("[servo] bad ch (0..%d)\n", PCA9685_MAX_CH-1);
      else if (us < SERVO_US_MIN || us > SERVO_US_MAX) Serial.printf("[servo] bad us (%d..%d)\n", SERVO_US_MIN, SERVO_US_MAX);
      else {
        sweep_active = false;
        //g_servo_man_dev = d; g_servo_man_ch = ch; g_servo_man_us = us; g_servo_manual = true;
        g_servo_man_tbl[d][ch] = (uint16_t)us;   // latch this channel; others untouched
        g_servo_manual = true;
        Serial.printf("[servo] hold dev%c ch%d = %d us\n", 'A'+d, ch, us);      }
    } else Serial.println(F("[servo] usage: servo <A|B|C> <ch> <us> | servo off"));
  }
  else if (eq(tok[0], "sweep") && n >= 3) {
    int d = dev_index(tok[1]); int ch = atoi(tok[2]);
    uint16_t mn = (n >= 4) ? atoi(tok[3]) : 1000;
    uint16_t mx = (n >= 5) ? atoi(tok[4]) : 2000;
    uint32_t ms = (n >= 6) ? (uint32_t)atoi(tok[5]) : 2000;
    if (d < 0)                                Serial.println(F("[sweep] bad device (A/B/C)"));
    else if (ch < 0 || ch >= PCA9685_MAX_CH)  Serial.printf("[sweep] bad ch (0..%d)\n", PCA9685_MAX_CH-1);
    else if (mn < SERVO_US_MIN || mx > SERVO_US_MAX || mn >= mx || ms < 100)
                                              Serial.println(F("[sweep] bad range/period (min<max, in us limits, ms>=100)"));
    else {
      sweep_min = mn; sweep_max = mx; sweep_ms = ms; sweep_t0 = millis();
      step_active  = false;                    // sweep and step are mutually exclusive
      sweep_active = true;
      g_servo_wave_dev = (uint8_t)d; g_servo_wave_ch = (uint8_t)ch;
      g_servo_man_tbl[d][ch] = mn;             // seat start position in the table
      g_servo_manual = true;
      Serial.printf("[sweep] dev%c ch%d %u..%u us over %lu ms (servo off to stop)\n",
                    'A'+d, ch, mn, mx, (unsigned long)ms);
    }
  }
  else if (eq(tok[0], "step") && n >= 3) {
    int d = dev_index(tok[1]); int ch = atoi(tok[2]);
    uint16_t b  = (n >= 4) ? atoi(tok[3]) : 1000;   // begin us
    uint16_t e  = (n >= 5) ? atoi(tok[4]) : 2000;   // end us
    uint16_t sz = (n >= 6) ? atoi(tok[5]) : 100;    // step size us (magnitude)
    uint32_t dw = (n >= 7) ? (uint32_t)atoi(tok[6]) : 200;  // dwell ms per step
    if (d < 0)                                Serial.println(F("[step] bad device (A/B/C)"));
    else if (ch < 0 || ch >= PCA9685_MAX_CH)  Serial.printf("[step] bad ch (0..%d)\n", PCA9685_MAX_CH-1);
    else if (b < SERVO_US_MIN || b > SERVO_US_MAX ||
             e < SERVO_US_MIN || e > SERVO_US_MAX)  Serial.printf("[step] bad us (%d..%d)\n", SERVO_US_MIN, SERVO_US_MAX);
    else if (sz == 0 || dw < 20)              Serial.println(F("[step] bad size/dwell (size>0, dwell>=20ms)"));
    else {
      step_begin = b; step_end = e;
      step_size  = (e >= b) ? (int32_t)sz : -(int32_t)sz;   // sign toward end
      step_dwell = dw; step_t0 = millis();
      sweep_active = false;                    // step and sweep are mutually exclusive
      step_active  = true;
      g_servo_wave_dev = (uint8_t)d; g_servo_wave_ch = (uint8_t)ch;
      g_servo_man_tbl[d][ch] = b;              // seat the first step immediately
      g_servo_manual = true;
      Serial.printf("[step] dev%c ch%d %u->%u us, %ld us/step, %lu ms dwell (servo off to stop)\n",
                    'A'+d, ch, b, e, (long)step_size, (unsigned long)dw);
    }
  }
  else if (eq(tok[0], "mdot") && n >= 2) { g_status.mdot_target = atof(tok[1]); Serial.printf("[mdot] target=%.1f\n",(double)g_status.mdot_target); }
  else if (eq(tok[0], "sens")) {
    SensorFrame fr;
    if (!g_sensor_pub.read_latest(fr)) { Serial.println(F("[sens] no frame")); return; }
    for (int v = 0; v < VALVE_COUNT; ++v) {
      //if (fr.p_up[v] <= 0.0f && fr.p_lo[v] <= 0.0f) continue;   // skip unpopulated valves
      float dpraw  = fr.p_up[v] - fr.p_lo[v];
      float dpcorr = dpraw - g_dp_zero[v];
      Serial.printf("[sens] v%d pu=%.2f pl=%.2f dpraw=%.2f dpz=%.2f dpcorr=%.2f mbar t=%.2f C mdot=%.3f g/s %s\n",
        v, (double)fr.p_up[v], (double)fr.p_lo[v], (double)dpraw,
        (double)g_dp_zero[v], (double)dpcorr, (double)fr.t_die[v],
        (double)fr.mdot[v], vh_name(fr.why[v]));
    }
    Serial.printf("[sens] total=%.3f g/s  nvalid=%u\n", (double)fr.mdot_total, fr.n_valid); 
  }           
  else if (eq(tok[0], "map")) {
    // I13: the servo -> valve assignment lives in the calibration blob (LittleFS).
    // Physical output of servo s is fixed: board 'A'+s/4, channel s%4.
    if (n >= 3) {
      if (g_status.armed) { Serial.println(F("[map] refused: disarm first")); return; }
      int sv = atoi(tok[1]), vv = atoi(tok[2]);
      if (sv < 0 || sv >= SERVO_COUNT || vv < 0 || vv >= VALVE_COUNT) {
        Serial.printf("[map] usage: map S V   (S 0..%d, V 0..%d)\n", SERVO_COUNT - 1, VALVE_COUNT - 1);
        return;
      }
      g_servo_valve_map[sv] = (uint8_t)vv;
      Serial.printf("[map] servo %d (board %c ch%d) -> valve %d  (not saved: 'save' to persist)\n",
                    sv, 'A' + sv / VALVE_SERVOS_PER_PCA, sv % VALVE_SERVOS_PER_PCA, vv + 1);
    }
    int per[VALVE_COUNT] = {0};
    for (int sv = 0; sv < SERVO_COUNT; ++sv) {
      int vv = g_servo_valve_map[sv];
      if (vv < VALVE_COUNT) per[vv]++;
      Serial.printf("[map] servo %2d  board %c ch%d  -> valve %d\n",
                    sv, 'A' + sv / VALVE_SERVOS_PER_PCA, sv % VALVE_SERVOS_PER_PCA, vv + 1);
    }
    for (int vv = 0; vv < VALVE_COUNT; ++vv)
      if (per[vv] != 2) Serial.printf("[map] NOTE valve %d has %d servo(s) (expected 2)\n", vv + 1, per[vv]);
  }
  else if (eq(tok[0], "save")) {
    // Flash writes pause core 1 (sensor reads + servo writes): never while armed.
    if (g_status.armed) { Serial.println(F("[cal] refused: disarm first")); return; }
    Serial.println(cal_save() ? F("[cal] saved") : F("[cal] SAVE FAILED"));
  }
  else if (eq(tok[0], "zero")) {
    // Capture the current no-flow (p_up - p_lo) per valve as the offset. MUST be
    // done at genuine no-flow (compressor stopped, still air).
    if (g_status.armed) { Serial.println(F("[zero] refused: disarm first (needs no flow)")); return; }
    if (g_last_armed_ms != 0 && (millis() - g_last_armed_ms) < ZERO_SETTLE_MS) {
      Serial.printf("[zero] refused: rotor may still be coasting; wait %lu s after disarm\n",
                    (unsigned long)((ZERO_SETTLE_MS - (millis() - g_last_armed_ms)) / 1000 + 1));
      return;
    }
    SensorFrame fr;
    if (!g_sensor_pub.read_latest(fr)) { Serial.println(F("[zero] no sensor frame")); return; }
    int n = 0;
    for (int v = 0; v < VALVE_COUNT; ++v) {
      // Only from a venturi whose sensors are healthy: an offset captured from a
      // stale / frozen sensor would bias dp for good. DPNEG is the exception --
      // a large raw offset between the pair is exactly what 'zero' removes.
      bool healthy = (fr.why[v] == VH_OK || fr.why[v] == VH_DPNEG);
      float off = fr.p_up[v] - fr.p_lo[v];
      if (healthy && fr.p_up[v] > 0.0f && fr.p_lo[v] > 0.0f && fabsf(off) > ZERO_MAX_OFFSET) {
        Serial.printf("[zero] v%d refused: offset %.2f mbar > %.1f -- check sensors/ports (kept %.2f)\n",
                      v, (double)off, (double)ZERO_MAX_OFFSET, (double)g_dp_zero[v]);
      } else if (healthy && fr.p_up[v] > 0.0f && fr.p_lo[v] > 0.0f) {
        g_dp_zero[v] = off;
        n++;
      } else if (fr.p_up[v] > 0.0f || fr.p_lo[v] > 0.0f) {
        Serial.printf("[zero] v%d skipped: %s (kept %.2f mbar)\n", v, vh_name(fr.why[v]),
                      (double)g_dp_zero[v]);
      }
    }
    bool ok = cal_save();
    Serial.printf("[zero] captured %d valve(s); save %s\n", n, ok ? "OK" : "FAILED");
  }
  else if (eq(tok[0], "calshow")) {
    Serial.printf("[cal] /cal.bin (map, gain/bias, zero): %s\n", g_cal_from_flash ? "loaded from flash" : "compiled defaults");
    servo_cal_report(true);
    Serial.print("[cal] valve gain/bias =");
    for (int v = 0; v < VALVE_COUNT; ++v) Serial.printf(" %.2f/%+.2f", (double)g_valve_gain[v], (double)g_valve_bias[v]);
    Serial.println();
    Serial.print("[cal] dp_zero =");
    for (int v = 0; v < VALVE_COUNT; ++v) Serial.printf(" %.2f", (double)g_dp_zero[v]);
    Serial.println(" mbar");
  }
   else if (eq(tok[0], "sbus")) {
#if USE_REAL_SBUS
    sbus_real_print();
#else
    Serial.println(F("[sbus] USE_REAL_SBUS=0 (simulated); use 'stick' / 'st'"));
#endif
}
  else { Serial.printf("? %s (try 'help')\n", tok[0]); }
}

// Fed one byte at a time by framing_pump() in text mode.
void console_feed_char(uint8_t c) {
  if (c == '\r') return;
  if (c == '\n') { con_line[con_len] = 0; if (con_len) dispatch(con_line); con_len = 0; return; }
  if (con_len < sizeof(con_line) - 1) con_line[con_len++] = (char)c;
}

void console_service(uint32_t now) {
  // servo sweep waveform: triangle min->max->min over sweep_ms; core 1 writes it
  if (g_servo_manual && sweep_active) {
  if (g_servo_manual && sweep_active)
    g_servo_man_tbl[g_servo_wave_dev][g_servo_wave_ch] = sweep_us_at(now);
  }
  else if (g_servo_manual && step_active) {
    uint32_t elapsed = now - step_t0;
    uint32_t nsteps  = elapsed / step_dwell;                 // how many dwell periods elapsed
    int32_t  us      = (int32_t)step_begin + (int32_t)nsteps * step_size;
    // clamp to the end and stop advancing once reached
    if (step_size > 0 && us >= (int32_t)step_end) us = step_end;
    if (step_size < 0 && us <= (int32_t)step_end) us = step_end;
    g_servo_man_tbl[g_servo_wave_dev][g_servo_wave_ch] = (uint16_t)us;
    // (leave step_active set so it HOLDS at step_end; 'servo off' to release)
  }

  // 2 Hz calibration stream for LabVIEW: all 12 pressures (!A)
  // and all 12 temps (!B), fixed width -- unpopulated valves read 0 until wired.
  if (con_pstream) {
    static uint32_t last_ps = 0;
    if ((now - last_ps) >= 500) {
      last_ps = now;
      SensorFrame fr;
      if (g_sensor_pub.read_latest(fr)) {
        Serial.print("!A");
        for (int v = 0; v < VALVE_COUNT; ++v)
          Serial.printf(",%.3f,%.3f", (double)fr.p_up[v], (double)fr.p_lo[v]);
        Serial.println();
        Serial.print("!B");
        for (int v = 0; v < VALVE_COUNT; ++v)
          Serial.printf(",%.3f,%.3f", (double)fr.t_die[v], (double)fr.t_lo[v]);
        Serial.println();
      }
    }
  }

  if (!con_mon_on) return;
  static uint32_t last = 0;
  if ((now - last) < 500) return;
  last = now;
  print_status();
}
