mattmccrink/afc-drone/rp2350_valve_node/types.h

// =============================================================================
//  types.h  --  Shared data structures + lock-free inter-core publisher
// =============================================================================
#pragma once
#include <Arduino.h>
#include "config.h"

// -----------------------------------------------------------------------------
//  Inter-core payloads  (mirror the architecture spec, section 5)
// -----------------------------------------------------------------------------

// core 0 -> core 1 : commanded valve positions (aero intent)
struct ValveCmd {
  int16_t  valve[VALVE_COUNT];   // aero-intent positions
  int16_t  surf[SURF_COUNT];     // surface commands, [-1000,1000], 0 = configured center
  uint32_t stamp_ms;             // set by core 0; core 1 checks staleness
};

// Why a venturi is (in)valid -- per valve, in SensorFrame.why[]. Worst-first
// order is not implied; the first failing check wins (see sensors.ino).
enum VentHealth : uint8_t {
  VH_OK = 0,
  VH_UNMAPPED,     // no up/lo pair in SENSOR_MAP
  VH_NOPROM,       // a sensor's PROM read/CRC failed at boot (never usable)
  VH_NODATA,       // no reading yet since boot
  VH_STALE,        // a sensor stopped answering (no good read within SENS_*STALE_MS)
  VH_FROZEN,       // a sensor returns identical raw counts (SENS_FROZEN_N)
  VH_LOSSY,        // a sensor fails too many reads (SENS_FAIL_WEIGHT / SENS_FAIL_TRIP)
  VH_RANGE,        // pressure / temperature outside physical limits
  VH_DPNEG,        // throat above upstream beyond VENTURI_DP_NEG_MAX
  VH_RECOVER,      // was faulty; waiting out SENS_RECOVER_MS clean time
  VH_INJECTED,     // console 'fault' injection
};

inline const char* vh_name(uint8_t w) {
  switch (w) {
    case VH_OK:       return "OK";
    case VH_UNMAPPED: return "UNMAPPED";
    case VH_NOPROM:   return "NOPROM";
    case VH_NODATA:   return "NODATA";
    case VH_STALE:    return "STALE";
    case VH_FROZEN:   return "FROZEN";
    case VH_LOSSY:    return "LOSSY";
    case VH_RANGE:    return "RANGE";
    case VH_DPNEG:    return "DPNEG";
    case VH_RECOVER:  return "RECOVER";
    case VH_INJECTED: return "INJECTED";
    default:          return "?";
  }
}

// core 1 -> core 0 : sensor + resolved-servo frame
struct SensorFrame {
  float    p_up[VALVE_COUNT];    // upstream pressure  (mbar)
  float    p_lo[VALVE_COUNT];    // throat pressure    (mbar)
  float    t_die[VALVE_COUNT];   // upstream sensor die temp (°C) -- density temp
  float    t_lo[VALVE_COUNT];    // throat sensor die temp (°C) -- cal/tempco telemetry
  float    mdot[VALVE_COUNT];    // per-valve mass flow (g/s)
  float    mdot_total;           // summed over VALID valves only
  uint16_t servo_us[SERVO_COUNT];// resolved servo commands (telemetry echo)
  uint8_t  valid[VALVE_COUNT];   // per-valve validity flag (see sensors_sim)
  uint8_t  why[VALVE_COUNT];     // VentHealth reason (VH_OK when valid)
  uint8_t  n_valid;              // count of valid valves
};

// -----------------------------------------------------------------------------
//  Node enums + app-level structs
//  (defined here, not in the main .ino, so Arduino's auto-generated prototypes
//   -- which are hoisted above the main sketch body -- can see these types.)
// -----------------------------------------------------------------------------
enum Source   { SRC_PRIMARY = 0, SRC_SBUS = 1, SRC_SAFE = 2 };
enum CompMode { COMP_STOPPED = 0, COMP_TRACK, COMP_DIRECT, COMP_FALLBACK };

// Derived operating mode for the fault-tree dashboard (single source of truth on
// the tiny; mirrored into CTRL_TLM -> /afc/health). Precedence: terminated wins,
// then disarmed, then the active source.
enum NodeMode : uint8_t {
  MODE_DISARMED       = 0,
  MODE_PRIMARY_ARMED  = 1,
  MODE_SBUS_REVERSION = 2,
  MODE_SAFE_HOLD      = 3,   // armed, no live source (pre-termination debounce)
  MODE_TERMINATED     = 4,
};

// A normalized command input; shared shape for every source.
struct StickInput {
  float    roll, pitch, yaw, throttle;   // roll/pitch/yaw in [-1,1], throttle [0,1]
  float    mdot_target;                  // g/s (primary only; sbus uses direct rpm)
  bool     valid;
  uint32_t stamp_ms;
};

struct NodeStatus {
  Source   source          = SRC_SAFE;
  bool     armed           = false;
  bool     arm_live        = false;
  bool     primary_present = true;       // sim: "is the Pi/primary alive?"
  uint16_t rpm_target      = 0;
  CompMode comp_mode       = COMP_STOPPED;
  float    mdot_total      = 0.0f;
  float    mdot_target     = MDOT_TARGET_DEFAULT;
  uint8_t  n_valid         = 0;
  bool     flow_fallback   = false;
  bool     sensor_stale    = false;
  bool     terminated      = false;      // latched flight-termination (total comms loss)
  bool     surf_engaged    = false;      // surface switch state (SBUS switch or console force)
  bool     surf_active     = false;      // surfaces actually allocated (switch && live source && !term)
  bool     comp_thermal    = false;      // ESC thermal-derate suspected (advisory)
  uint8_t  air_sev         = 0;          // air-delivery severity (AirSev, air_state.h), debounced
  uint8_t  air_causes      = 0;          // AIR_C_* bits behind the level on display (held; CTRL_TLM byte 55)
  uint8_t  air_causes_now  = 0;          // AIR_C_* bits this instant (console 'air' only)
  uint32_t air_held_ms     = 0;          // millis() of the last evaluation supporting air_sev
};

// Measured compressor telemetry, latched from the Motor Teensy's ESCPID_comm.
// Defined once in teensy_rx.ino; read by compressor_update, framing, console.
struct CompTlm {
  bool     ok      = false;   // fresh reply within the stale window
  uint16_t volt_cv = 0;       // pack voltage, 0.01 V
  uint16_t amp_ca  = 0;       // ESC current, 0.01 A
  int16_t  rpm10   = 0;       // mechanical rpm, units of 10 rpm
  int8_t   err     = 0;       // ESCCMD err code (0 ok, -10 TLM_LOST)
  uint8_t  temp_c  = 0;       // ESC temperature, deg C
  uint32_t tlm_ms  = 0;       // millis() of last good frame
};
extern CompTlm g_comp;        // declaration only -- definition lives in teensy_rx.ino

// One physical MS5837 behind the mux tree: its mux, channel, and which
// (valve, role) it serves. The real sensor path (sensors.ino) walks a table of
// these; the mapping is data, so open decision #1 is an edit, not a rewrite.
struct SensorSlot {
  uint8_t mux;      // mux I2C address (e.g. 0x70)
  uint8_t ch;       // channel 0..7
  uint8_t valve;    // 0..VALVE_COUNT-1
  uint8_t role;     // ROLE_UP or ROLE_LO
};

// Calibration blob persisted to LittleFS (see cal_littlefs.ino). Defined here,
// not in the tab, so Arduino's hoisted prototypes for the helpers that take it
// by reference can see the type.
struct CalBlob {                   // "CAL3": servo curves are compiled (servo_cal.h), not stored
  uint32_t magic;
  uint8_t  servo_valve_map[SERVO_COUNT];
  float    valve_gain[VALVE_COUNT];
  float    valve_bias[VALVE_COUNT];
  float    dp_zero[VALVE_COUNT];   // per-valve no-flow (p_up - p_lo) offset, mbar
  uint32_t crc32;                  // over all preceding bytes
};
// Previous layout ("CAL2", with per-servo cubics): read once to migrate the
// map, gain/bias and zero offsets; its cubics are ignored.
struct CalBlobV2 {
  uint32_t magic;
  float    servo_cubic[SERVO_COUNT][4];
  uint8_t  servo_valve_map[SERVO_COUNT];
  float    valve_gain[VALVE_COUNT];
  float    valve_bias[VALVE_COUNT];
  float    dp_zero[VALVE_COUNT];
  uint32_t crc32;
};

// -----------------------------------------------------------------------------
//  age_ms -- age of a millis() stamp, safe against stamps "from the future".
//
//  loop() reads `now` once at the top; some producers stamp with their own later
//  millis() read (framing on_frame, SBUS decode, Teensy reply decode). When the
//  millisecond ticks between the two reads, the stamp is 1 ms AHEAD of `now` and
//  the plain unsigned (now - stamp) wraps to ~4.29e9: a fresh input judged
//  stale for that pass (2026-09-28 bench: TEENSY_LINK blips; SBUS freshness /
//  receiver-loss watchdog glitching the active source SBUS->SAFE for a frame).
//  Returns 0 for a stamp at or after `now`. Valid for real ages < ~24.8 days.
// -----------------------------------------------------------------------------
static inline uint32_t age_ms(uint32_t now, uint32_t stamp) {
  int32_t d = (int32_t)(now - stamp);
  return d > 0 ? (uint32_t)d : 0u;
}

// -----------------------------------------------------------------------------
//  SpscPublisher -- single-writer / single-reader lock-free publish.
//
//  Realized as a *seqlock* rather than a 2-buffer index flip: a plain double
//  buffer with a flipped index is NOT torn-read-safe if the reader can be slow
//  relative to the writer (writer may reopen the buffer the reader still holds).
//  A seqlock gives the same single-writer/single-reader publish the spec calls
//  for, with guaranteed torn-read safety and a natural staleness signal (the
//  monotonic `seq`). Writer bumps seq odd, writes, bumps seq even; reader
//  retries if it observes an odd or changed seq.
//
//  The odd window must stay SHORT: the writer builds the frame in a local and
//  calls publish(), which holds the window only for one struct copy (~1 us).
//  (2026-09-28: the writers used to compute the whole frame -- six venturis,
//  density, sqrt, health gating -- inside begin_write()/end_write(). Core 0 polls
//  every loop pass, so it landed in that window often, exhausted its retries in
//  well under a microsecond, and every caller treated the miss as "sensors
//  stale": one-pass VENT_LOST|SENSOR_STALE blips that held the air annunciator
//  up, zeroed SENSOR_TLM frames to the Pi, and reset the flow-trust debounce.)
//
//  Readers use read_latest(): a contended read returns the last good copy
//  instead of failing, so a collision is invisible. Staleness is judged ONLY by
//  `seq` not advancing (writer dead / hung), never by one missed read.
//  read_latest() keeps reader-side state: call it only from the reading core
//  (core 0 for g_sensor_pub).
// -----------------------------------------------------------------------------
template <typename T>
class SpscPublisher {
public:
  volatile uint32_t seq = 0;     // even = stable, odd = write in progress
  T data;

  // ---- writer side (call from exactly one core) ----
  // publish(): the only writer entry point -- odd window = one struct copy.
  void publish(const T& v) { seq++; __sync_synchronize(); data = v; __sync_synchronize(); seq++; }

  // ---- reader side (call from exactly one core) ----
  // Returns true and fills `out` with a clean snapshot; false if nothing has been
  // published yet, or no clean copy within the retry budget (writer contention).
  bool snapshot(T& out) {
    for (int tries = 0; tries < 64; ++tries) {
      uint32_t s0 = seq; __sync_synchronize();
      if (s0 == 0) return false;             // never published (after a 2^32 wrap this
                                             //   hides one frame; read_latest serves the cache)
      if (s0 & 1u) continue;                 // writer mid-update
      out = data; __sync_synchronize();
      uint32_t s1 = seq;
      if (s0 == s1) return true;             // stable across the copy
    }
    return false;
  }

  uint32_t sequence() const { return seq; }  // for non-advancing == stale checks

  // read_latest(): the newest clean snapshot, or -- if this read collided with
  // the writer -- the last good one. Returns false only before the first frame.
  // *fresh (optional) = this call got a new clean snapshot (for contention stats).
  bool read_latest(T& out, bool* fresh = nullptr) {
    bool ok = snapshot(out);
    if (ok) { last_ = out; have_ = true; }
    else if (have_) out = last_;
    if (fresh) *fresh = ok;
    return have_;
  }

private:
  T    last_{};            // reader-side cache (core 0 only)
  bool have_ = false;
};
