mattmccrink/afc-drone/rpi_ros2/src/afc_bridge/afc_bridge/framing.py

"""
framing.py -- Pi-side of the RP2350 valve-node link (Pi uart3 <-> Tiny Serial2).

Byte-for-byte compatible with the tiny's framing.ino:

    wire format:  [magic:4 LE][type:1][len:1][payload:len][crc8:1]
    crc8:         poly 0x07, init 0x00, over  type | len | payload   (NOT magic)
    reader:       magic-resync state machine -- never blocks, never flushes,
                  re-locks on the 4-byte magic after any garble (the teensyshot
                  host-link idiom, generalised from fixed 64 B to variable len).

Nothing here imports rclpy; the bridge node wires these into subscriptions and a
serial port. Everything is bounds-checked: len is a u8 (<=255) and the payload
buffer is sized to match, so no inbound frame can overrun.
"""
from __future__ import annotations

import struct
from dataclasses import dataclass
from typing import Iterator, Optional

# ---- protocol constants (mirror config.h) -----------------------------------
PI_MAGIC = 0x52503233           # 'RP23'; on the wire LE -> 33 32 50 52
PI_MAGIC_BYTES = struct.pack("<I", PI_MAGIC)

FT_CMD = 0x01                   # Pi -> node : fast command (6x int16)
FT_ARM = 0x02                   # Pi -> node : slow arm token {state:u8, counter:u32}
FT_CTRL_TLM = 0x81              # node -> Pi : control telemetry
FT_SENSOR_TLM = 0x82            # node -> Pi : sensor telemetry
FT_COMP_TLM = 0x83              # node -> Pi : measured compressor telemetry

# ---- CMD field scaling (mirror on_frame() in framing.ino) -------------------
# payload = 6x int16 LE at offsets 0,2,4,6,8,10:
#   roll, pitch, yaw, throttle  (x1000)   |  [8] unused  |  mdot_target (x10)
_SCALE_RPY = 1000.0
_SCALE_THR = 1000.0
_SCALE_MDOT = 10.0
_I16_MIN, _I16_MAX = -32768, 32767


def crc8(data: bytes) -> int:
    """CRC-8 poly 0x07, init 0x00, MSB-first. Identical to the tiny's crc8()."""
    c = 0
    for b in data:
        c ^= b
        for _ in range(8):
            c = ((c << 1) ^ 0x07) & 0xFF if (c & 0x80) else (c << 1) & 0xFF
    return c


def _clamp(x: float, lo: float, hi: float) -> float:
    return lo if x < lo else hi if x > hi else x


def _i16(x: float) -> int:
    v = int(round(x))
    return _I16_MIN if v < _I16_MIN else _I16_MAX if v > _I16_MAX else v


# ---- outbound frame writer --------------------------------------------------
def build_frame(ftype: int, payload: bytes = b"") -> bytes:
    """Frame a payload exactly as send_frame() expects to read it back."""
    if not 0 <= len(payload) <= 255:
        raise ValueError(f"payload len {len(payload)} exceeds u8 frame length")
    hdr = PI_MAGIC_BYTES + bytes((ftype & 0xFF, len(payload)))
    cc = crc8(hdr[4:] + payload)          # crc over type|len|payload
    return hdr + payload + bytes((cc,))


def build_cmd(roll: float, pitch: float, yaw: float,
              thrust: float, mdot_target: float,
              *, thrust_lo: float = 0.0, thrust_hi: float = 1.0) -> bytes:
    """Pack a FT_CMD frame from normalised, pre-mix control demand.

    roll/pitch/yaw are clamped to [-1, 1]; thrust to [thrust_lo, thrust_hi]
    (default [0, 1] -- widen to [-1, 1] for a reversible-thrust airframe);
    mdot_target in g/s. Offset [8] (the dead 'altitude' slot the tiny ignores)
    is sent as zero.
    """
    r = _i16(_clamp(roll,  -1.0, 1.0) * _SCALE_RPY)
    p = _i16(_clamp(pitch, -1.0, 1.0) * _SCALE_RPY)
    y = _i16(_clamp(yaw,   -1.0, 1.0) * _SCALE_RPY)
    t = _i16(_clamp(thrust, thrust_lo, thrust_hi) * _SCALE_THR)
    m = _i16(_clamp(mdot_target, 0.0, 400.0) * _SCALE_MDOT)
    payload = struct.pack("<6h", r, p, y, t, 0, m)
    return build_frame(FT_CMD, payload)


def build_arm(armed: bool, counter: int) -> bytes:
    """Pack a FT_ARM frame: state:u8, counter:u32 LE."""
    payload = struct.pack("<BI", 1 if armed else 0, counter & 0xFFFFFFFF)
    return build_frame(FT_ARM, payload)


# ---- inbound magic-resync reader --------------------------------------------
@dataclass
class Frame:
    type: int
    payload: bytes


class FrameReader:
    """Feed raw serial bytes in; get whole, CRC-checked frames out.

    Mirrors the tiny's parse_byte() state machine. A bad CRC or a garbled
    header costs at most one frame: the reader falls back into magic search and
    re-locks -- it never flushes the buffer and never blocks.
    """

    _MAGIC = 0                 # 0..3 = matching magic byte N
    _TYPE = 4
    _LEN = 5
    _PAYLOAD = 6
    _CRC = 7

    def __init__(self) -> None:
        self._state = self._MAGIC
        self._magic_pos = 0
        self._type = 0
        self._len = 0
        self._buf = bytearray()
        self.crc_errors = 0     # observability: count silently-dropped frames

    def feed(self, chunk: bytes) -> Iterator[Frame]:
        for byte in chunk:
            frame = self._step(byte)
            if frame is not None:
                yield frame

    def _step(self, c: int) -> Optional[Frame]:
        st = self._state
        if st == self._MAGIC:
            if c == PI_MAGIC_BYTES[self._magic_pos]:
                self._magic_pos += 1
                if self._magic_pos == 4:
                    self._magic_pos = 0
                    self._state = self._TYPE
            else:
                # resync: a fresh magic[0] restarts the match, else back to 0
                self._magic_pos = 1 if c == PI_MAGIC_BYTES[0] else 0
            return None
        if st == self._TYPE:
            self._type = c
            self._state = self._LEN
            return None
        if st == self._LEN:
            self._len = c
            self._buf.clear()
            self._state = self._PAYLOAD if c else self._CRC
            return None
        if st == self._PAYLOAD:
            self._buf.append(c)
            if len(self._buf) >= self._len:
                self._state = self._CRC
            return None
        # st == self._CRC
        self._state = self._MAGIC
        want = crc8(bytes((self._type, self._len)) + self._buf)
        if want == c:
            return Frame(self._type, bytes(self._buf))
        self.crc_errors += 1
        return None


# ---- node counts (mirror config.h) ------------------------------------------
VALVE_COUNT = 6
SERVO_COUNT = 12
SURF_COUNT = 4

# ---- inbound telemetry decoders (CTRL_TLM 0x81, SENSOR_TLM 0x82) ------------
# Mirror tlm_service() in framing.ino. Payload layouts:
#   CTRL_TLM   (43 B base): B source, B armed, B comp_mode, B flow_fallback,
#                      H rpm_target, B n_valid, 6h valve[], 12H servo_us[]
#   CTRL_TLM  (+4 B ext, 47 total): B mode, B flags(bit0 term,1 elig_fc [FC token
#                      recent],2 elig_sbus,3 sbus_sw,4 surf_engaged [surfaces ACTIVE:
#                      switch on AND live source AND not terminated],5 surf_switch),
#                      B desat_rp*100,
#                      B desat_yaw*100
#   CTRL_TLM  (+8 B ext2, 55 total): 4h surf[] command, [-1000,1000], 0 = center
#   CTRL_TLM  (+1 B ext3, 56 total): B air_causes
#   CTRL_TLM  (+1 B ext4, 57 total): B flags2 (SBUS link + build configuration)
#   CTRL_TLM  (+4 B ext5, 61 total): I node_stamp_ms (tiny millis() at frame build,
#                      same clock as SENSOR_TLM / COMP_TLM node_stamp_ms)
#   CTRL_TLM (+18 B ext6, 79 total): 4I SBUS frames / frame-lost flagged / failsafe
#                      flagged / wire-rejected (cumulative since boot, u32 wrap),
#                      H worst clean-frame gap ms over the last two CTRL_TLM periods
#   SENSOR_TLM (56 B): 6h p_up*10, 6h p_lo*10, 6h t_die*100, 6h mdot*10,
#                      1h mdot_total*10, H valid_mask, I node_stamp_ms
#   COMP_TLM   (13 B): H volt*100, H amp*100, h rpm/10, B temp_c, b err, B ok,
#                      I node_ms
#   COMP_TLM  (+1 B ext, 14 total): B flags (bit0 ESC thermal-derate suspect)
# Every extension is APPENDED; shorter (older-firmware) frames decode with defaults.
CTRL_TLM_LEN = 43
CTRL_TLM_LEN_EXT = 47
CTRL_TLM_LEN_EXT2 = 55
CTRL_TLM_LEN_EXT3 = 56          # + air_causes byte (air-delivery severity rides flags bits 6-7)
CTRL_TLM_LEN_EXT4 = 57          # + flags2 (SBUS link + build-configuration notices)
CTRL_TLM_LEN_EXT5 = 61          # + node_stamp_ms (u32), 2026-09-29
CTRL_TLM_LEN_EXT6 = 79          # + RC link quality (SBUS counters + worst gap), 2026-10-01
SENSOR_TLM_LEN_EXT = 62         # + per-venturi validity reason (6 x u8, VentHealth)

# Tiny VentHealth reasons (types.h) -- why a venturi is (in)valid
VH_NAMES = {0: "OK", 1: "UNMAPPED", 2: "NOPROM", 3: "NODATA", 4: "STALE", 5: "FROZEN",
            6: "LOSSY", 7: "RANGE", 8: "DPNEG", 9: "RECOVER", 10: "INJECTED"}

# Air-delivery severity (tiny air_state.h). Reporting only.
AIR_OK, AIR_ADVISORY, AIR_CAUTION, AIR_WARNING = 0, 1, 2, 3
AIR_NAMES = {0: "OK", 1: "ADVISORY", 2: "CAUTION", 3: "WARNING"}
AIR_CAUSES = {0x01: "TLM_LOST", 0x02: "TLM_EMU", 0x04: "VENT_PARTIAL", 0x08: "VENT_LOST",
              0x10: "FLOW_LOW", 0x20: "SENSOR_STALE", 0x40: "TEENSY_LINK"}
SENSOR_TLM_LEN = 56
COMP_TLM_LEN = 13
COMP_TLM_LEN_EXT = 14

def decode_ctrl_tlm(payload: bytes) -> dict:
    if len(payload) < CTRL_TLM_LEN:
        raise ValueError(f"CTRL_TLM short: {len(payload)} < {CTRL_TLM_LEN}")
    source, armed, comp_mode, flow_fb, rpm_target, n_valid = \
        struct.unpack_from("<BBBBHB", payload, 0)
    valve = list(struct.unpack_from("<6h", payload, 7))
    servo_us = list(struct.unpack_from("<12H", payload, 19))
    d = dict(source=source, armed=bool(armed), comp_mode=comp_mode,
             flow_fallback=bool(flow_fb), rpm_target=rpm_target,
             n_valid=n_valid, valve=valve, servo_us=servo_us,
             # defaults for pre-update firmware (43-byte frames):
             mode=0, terminated=False, elig_fc=False, elig_sbus=False,
             sbus_sw=False, surf_engaged=False, surf_switch=False,
             desat_rp=1.0, desat_yaw=1.0,
             surf=[0] * SURF_COUNT, air_sev=0, air_causes=0,
             # flags2 defaults (pre-2026-09-27 firmware): unknown -> benign
             sbus_lost=False, sbus_ok=False, bench_build=False, cal_flash=False,
             sim_sensors=False, sim_sbus=False, sim_primary=False, flags2_valid=False,
             # node clock (pre-2026-09-29 firmware): 0 = not reported
             node_stamp_ms=0,
             # RC link quality (pre-2026-10-01 firmware): not reported
             sbus_stats_valid=False, sbus_n_frames=0, sbus_n_lost=0, sbus_n_fs=0,
             sbus_n_bad=0, sbus_gap_ms=0)
    if len(payload) >= CTRL_TLM_LEN_EXT:
        mode, flags, drp, dyaw = struct.unpack_from("<BBBB", payload, 43)
        d.update(mode=mode, terminated=bool(flags & 0x01),
                 elig_fc=bool(flags & 0x02), elig_sbus=bool(flags & 0x04),
                 sbus_sw=bool(flags & 0x08), surf_engaged=bool(flags & 0x10),
                 surf_switch=bool(flags & 0x20),
                 desat_rp=drp / 100.0, desat_yaw=dyaw / 100.0)
        # bits 6-7 were always 0 on older firmware -> AIR_OK, so no length gate needed
        d.update(air_sev=(flags >> 6) & 0x03)
    if len(payload) >= CTRL_TLM_LEN_EXT2:
        d.update(surf=list(struct.unpack_from("<4h", payload, 47)))
    if len(payload) >= CTRL_TLM_LEN_EXT3:
        d.update(air_causes=payload[55])
    if len(payload) >= CTRL_TLM_LEN_EXT4:
        f2 = payload[56]
        d.update(sbus_lost=bool(f2 & 0x01), sbus_ok=bool(f2 & 0x02), bench_build=bool(f2 & 0x04),
                 cal_flash=bool(f2 & 0x08), sim_sensors=bool(f2 & 0x10), sim_sbus=bool(f2 & 0x20),
                 sim_primary=bool(f2 & 0x40), flags2_valid=True)
    if len(payload) >= CTRL_TLM_LEN_EXT5:
        d.update(node_stamp_ms=struct.unpack_from("<I", payload, 57)[0])
    if len(payload) >= CTRL_TLM_LEN_EXT6:
        n, lost, fs, bad, gap = struct.unpack_from("<IIIIH", payload, 61)
        d.update(sbus_stats_valid=True, sbus_n_frames=n, sbus_n_lost=lost, sbus_n_fs=fs,
                 sbus_n_bad=bad, sbus_gap_ms=gap)
    return d


def decode_sensor_tlm(payload: bytes) -> dict:
    if len(payload) < SENSOR_TLM_LEN:
        raise ValueError(f"SENSOR_TLM short: {len(payload)} < {SENSOR_TLM_LEN}")
    p_up = [x / 10.0 for x in struct.unpack_from("<6h", payload, 0)]
    p_lo = [x / 10.0 for x in struct.unpack_from("<6h", payload, 12)]
    t_die = [x / 100.0 for x in struct.unpack_from("<6h", payload, 24)]
    mdot = [x / 10.0 for x in struct.unpack_from("<6h", payload, 36)]
    (mdot_total,) = struct.unpack_from("<h", payload, 48)
    (mask,) = struct.unpack_from("<H", payload, 50)
    (node_stamp_ms,) = struct.unpack_from("<I", payload, 52)
    valid = [bool((mask >> v) & 1) for v in range(VALVE_COUNT)]
    # per-venturi reason (62-byte firmware); older frames: 0 (OK) if valid else 255 (unknown)
    if len(payload) >= SENSOR_TLM_LEN_EXT:
        why = list(payload[56:56 + VALVE_COUNT])
    else:
        why = [0 if ok else 255 for ok in valid]
    return dict(p_up=p_up, p_lo=p_lo, t_die=t_die, mdot=mdot,
                mdot_total=mdot_total / 10.0, valid=valid,
                node_stamp_ms=node_stamp_ms, why=why)

def decode_comp_tlm(payload: bytes) -> dict:
    if len(payload) < COMP_TLM_LEN:
        raise ValueError(f"COMP_TLM short: {len(payload)} < {COMP_TLM_LEN}")
    volt_cv, amp_ca, rpm10, temp_c, err, ok = \
        struct.unpack_from("<HHhBbB", payload, 0)
    (node_ms,) = struct.unpack_from("<I", payload, 9)
    flags = payload[13] if len(payload) >= COMP_TLM_LEN_EXT else 0
    return dict(volt=volt_cv / 100.0, amp=amp_ca / 100.0,
                rpm=rpm10 * 10, temp_c=temp_c, err=err,
                tlm_ok=bool(ok), node_stamp_ms=node_ms,
                thermal_suspect=bool(flags & 0x01))
