mattmccrink/afc-drone/(commit log)

2026-09-08 Initial import: teensy + rp2350 firmware, docs, host tools
2026-09-08 Changed timing on OSR to support bad sensor that requires higher ADC conversion time.
2026-09-08 Update sensors.ino
    Eelco test commit
2026-09-08 changed i2c mux addresses to deconflict with 0x70 all call
2026-09-09 Servo debug, failed components identified
    [console.ino, rp2350_valve_node.ino, sensors.ino, servos.ino]
2026-09-09 Addres exploration to try and unstick servo drivers, failed
    [config.h]
2026-09-10 added servo step functionality.
2026-09-10 Venturi Calibration
    Calibrated Venturis and changed direction of positive pressure (removed leading negative of dP)
2026-09-12 time base correction and bring up on the RPI
    [bridge_node.py]
2026-09-13 dds debug check for 1hz delay
2026-09-13 DDS 1hz stall fix by issuing offboard control command
    [bridge_node.py]
2026-09-14 2350 sim data present during ground runs, missing flag
    [config.h, rp2350_valve_node.ino]
2026-09-14 fixed pointer to vehicle health
    [bridge_node.py]
2026-09-14 added valve allocation scheme to balance output from valves
2026-09-15 debug valve positions
2026-09-15 valve command fix for core0/1 race and allocation math
    [allocation.ino, compressor.ino, config.h, console.ino, framing.ino, rp2350_valve_node.ino]
2026-09-15 fixed early terminate on boot enum error
    [arbitration.ino]
2026-09-23 removed link_test on Tiny compressor, and 3D mode for Teensy
2026-09-26 Added bench test hooks for Tiny2350 to exercise failure modes
    [Arduino.h, compressor.ino, config.h, console.ino, rp2350_valve_node.ino, sensors.ino, sensors_sim.ino, test_vent_health.cpp]
2026-09-27 teensy cleanup and PID hardening. Added sim tool to exercise DSHOT
2026-09-28 Timing issue fix for sbus and air timeouts
    [allocation.ino, arbitration.ino, compressor.ino, config.h, console.ino, framing.ino, sbus_real.ino, sensors.ino]
2026-09-29 afc_bridge_run.sh: track executable bit
2026-09-30 tools: track executable bit on preflight and pi_setup scripts
2026-09-30 servo mapping patch
2026-09-30 i2c stuck bus fix
    [bench_i2c.ino, cal_littlefs.ino, config.h, console.ino, framing.ino, i2c_guard.ino, rp2350_valve_node.ino]
2026-10-02 sbus error flags for dashboard
    [bridge_node.py, framing.ino, framing.py, rp2350_valve_node.ino, sbus_real.ino]
